thaobk91/smf/ảnh/netajet_high_flow_installation.jpg

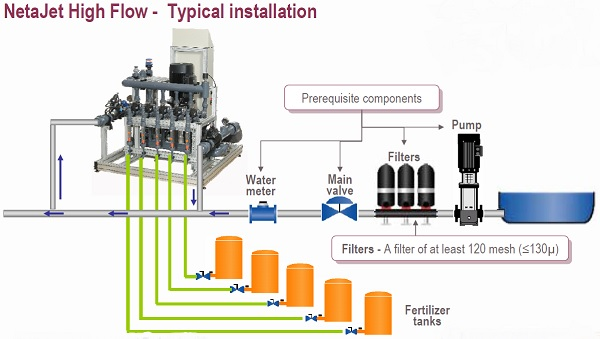
ảnh/netajet_high_flow_installation.jpg
