thaobk91/smf/ảnh/CMT-2.png

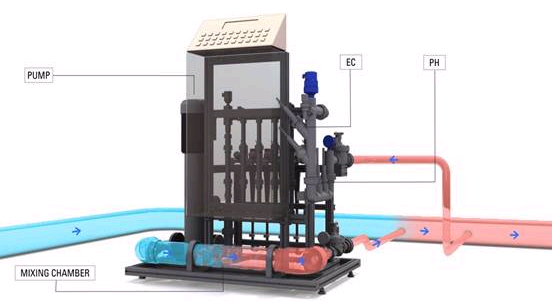
ảnh/CMT-2.png
