thaobk91/smf/image.png

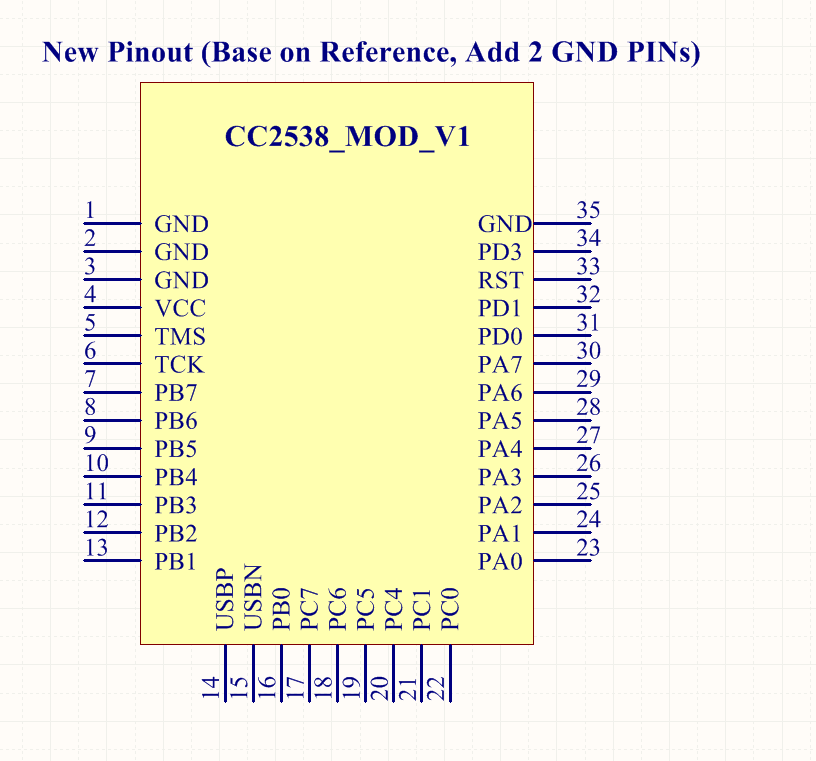
image.png
