thaobk91/smf/ảnh/cmt4.jpg

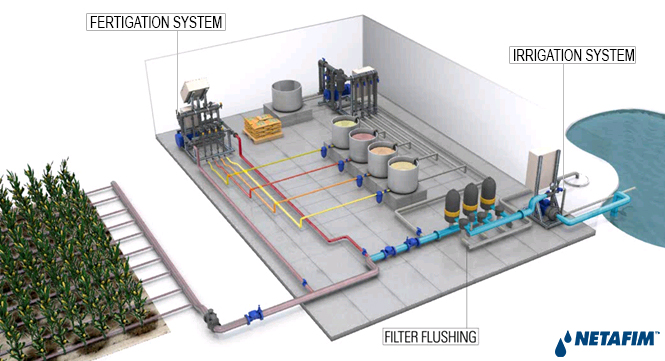
ảnh/cmt4.jpg
