thaobk91/smf/ảnh/FertirrigacionXILEMA2l.jpg

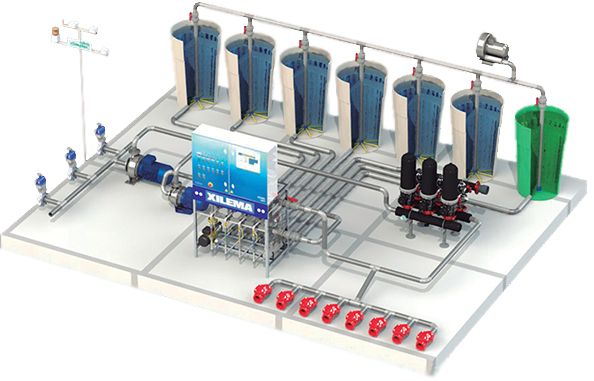
ảnh/FertirrigacionXILEMA2l.jpg
