thaobk91/smf/HW/Schematic Prints(3).PDF

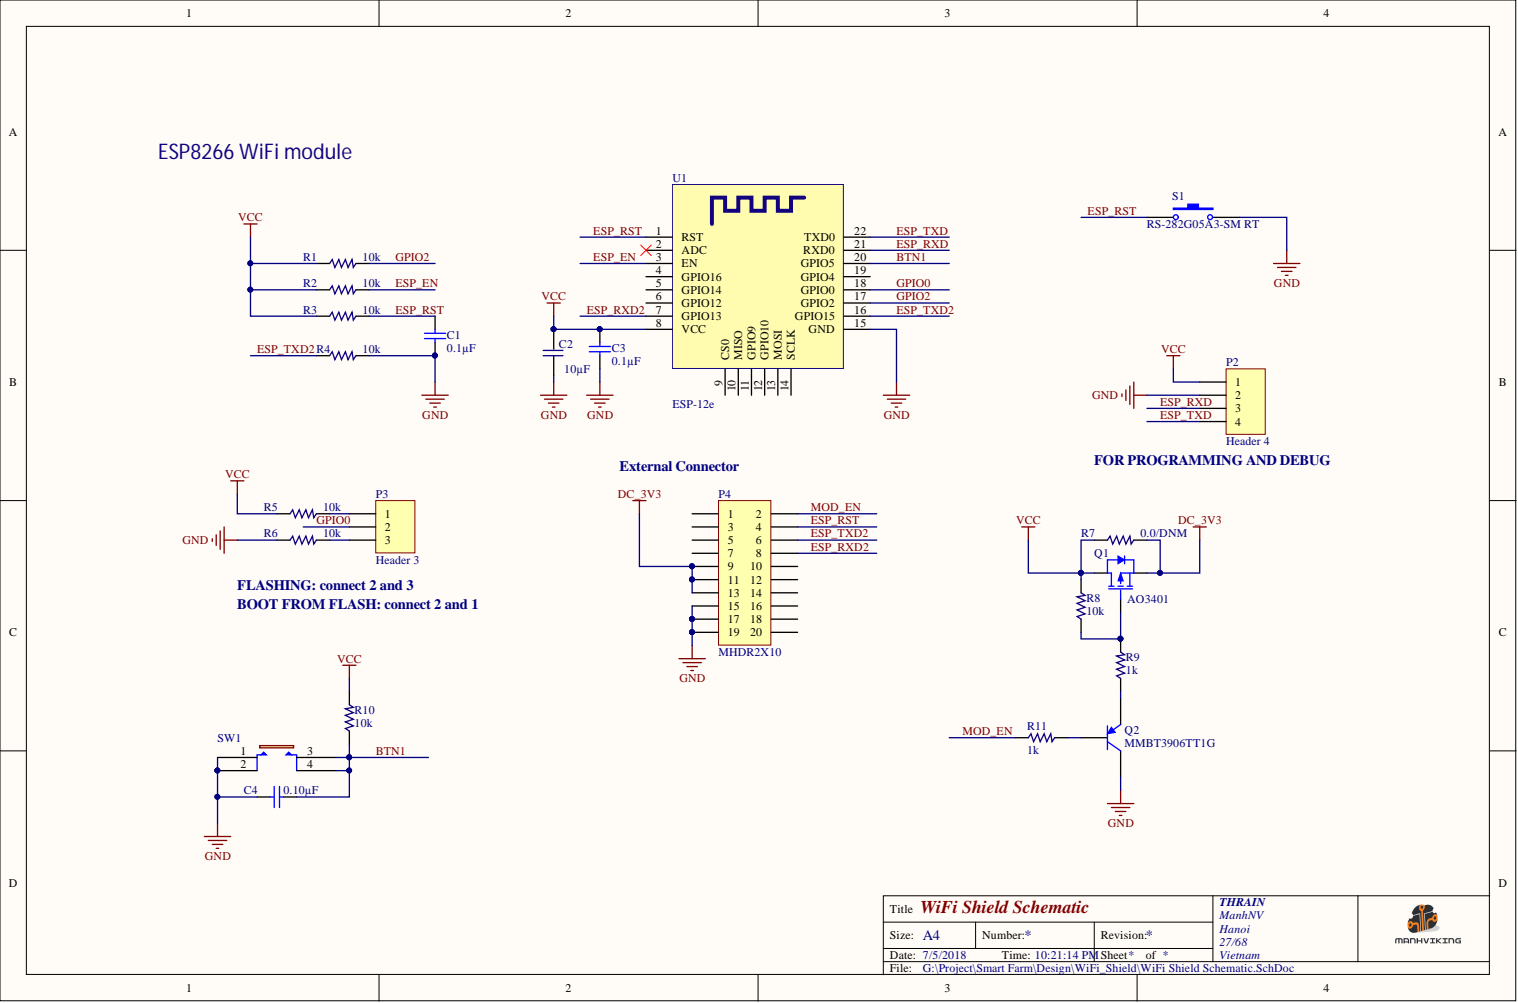
[picture p6: page 1]

FOR PROGRAMMING AND DEBUG

FLASHING: connect 2 and 3
BOOT FROM FLASH: connect 2 and 1

Title WiFi Shield Schematic | THRAIN ManhNV Hanoi 27/68 Vietnam

Size: A4 | Number: * | Revision: *
Date: 7/5/2018 Time: 10:21:14 PM | | Sheet * of *

G:\Project\Smart Farm\Design\WiFi_Shield\WiFi Shield Schematic.SchDoc
