thaobk91/smf/HW/WiFi_Shield 182806/PDF/Schematic Prints.PDF

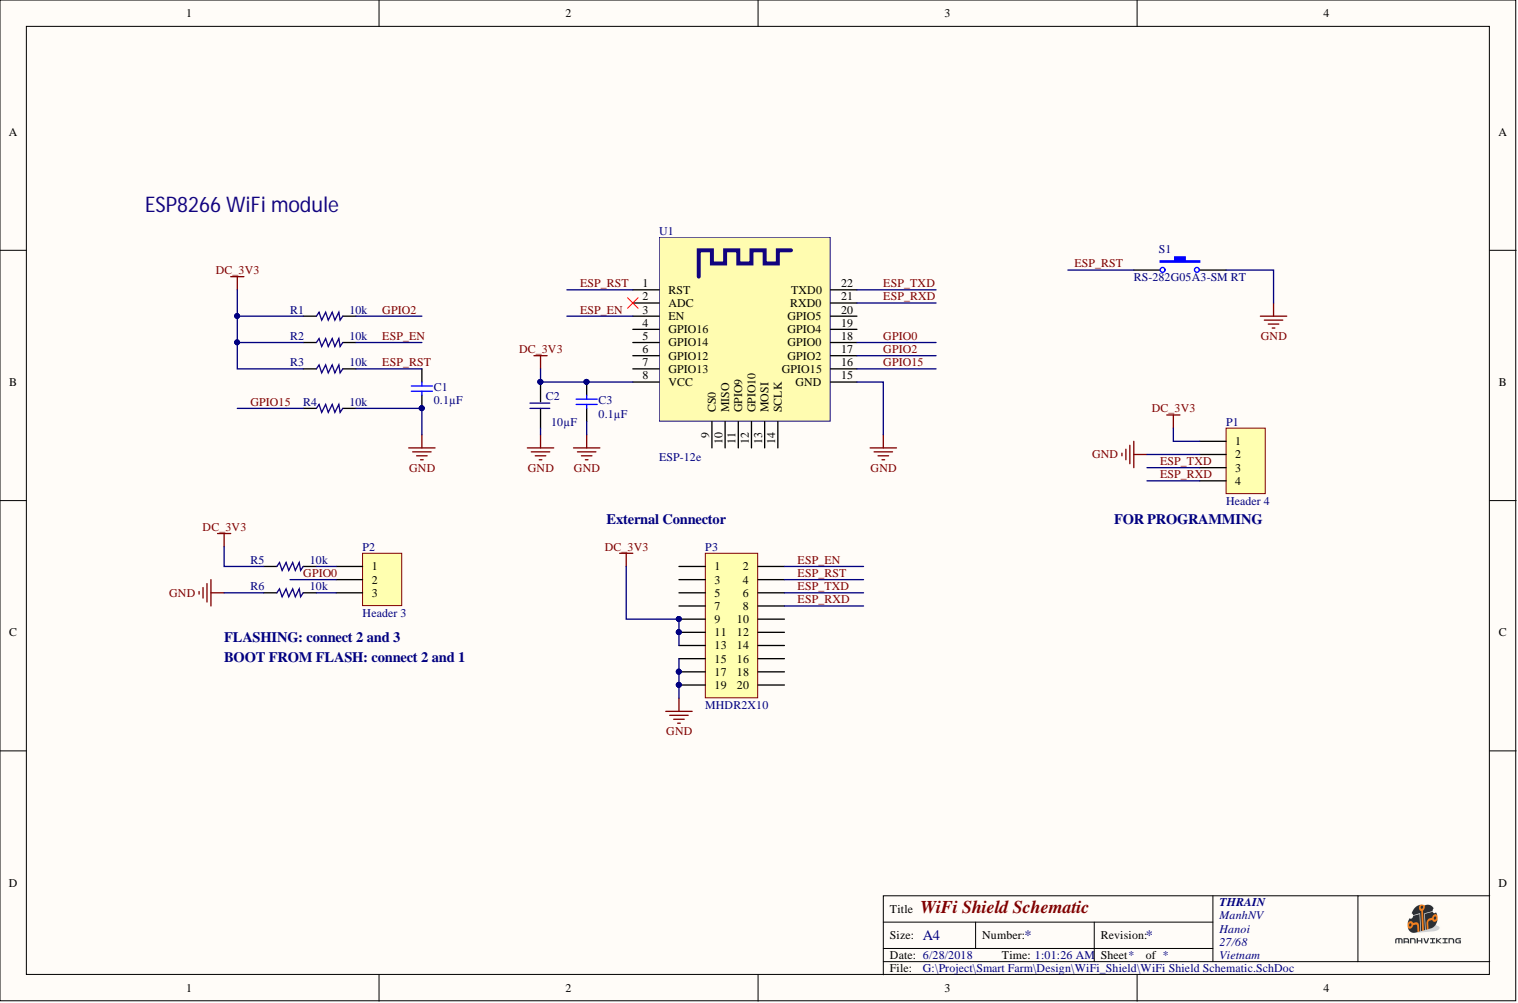
[picture p7: page 1]

FLASHING: connect 2 and 3
BOOT FROM FLASH: connect 2 and 1

Title WiFi Shield Schematic | THRAIN ManhNV Hanoi 27/68 Vietnam

Size: A4 | Number: * | Revision: *
Date: 6/28/2018 Time: 1:01:26 AM | | Sheet * of *

G:\Project\Smart Farm\Design\WiFi_Shield\WiFi Shield Schematic.SchDoc
