thaobk91/smf/HW/GatewayLayer.pdf

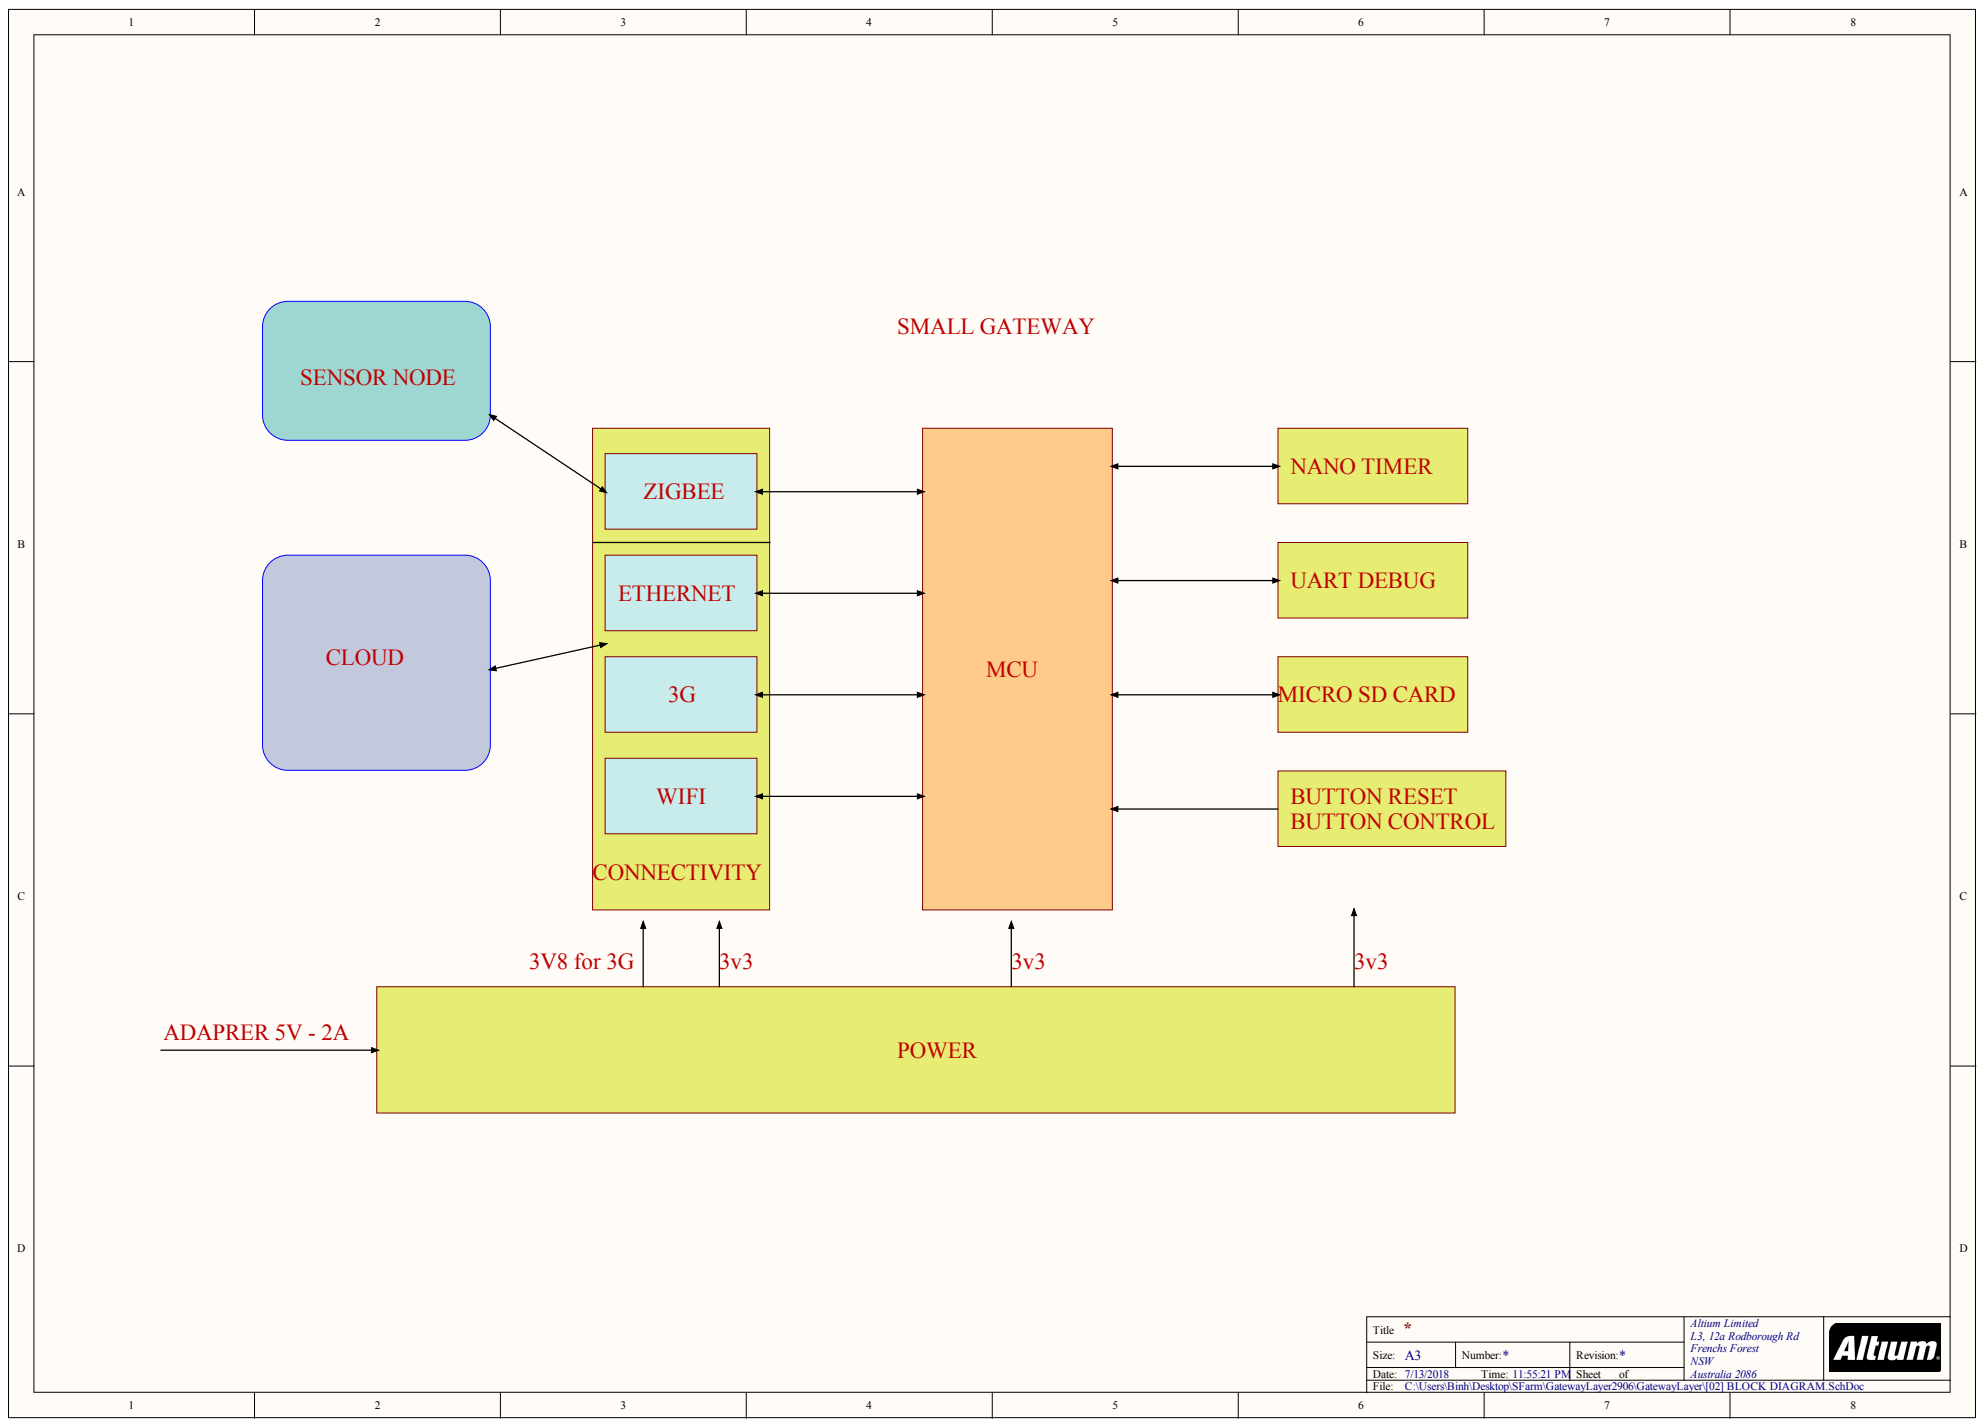
[picture p8: page 1]

* Title | Altium Limited L3, 12a Rodborough Rd Frenchs Forest NSW Australia 2086

Size: A3 | Number: * | Revision: *

Date: 7/13/2018 Time: 11:55:21 PM | | Sheet of

C:\Users\Binh\Desktop\SFarm\GatewayLayer2906\GatewayLayer\[02] BLOCK DIAGRAM.SchDoc

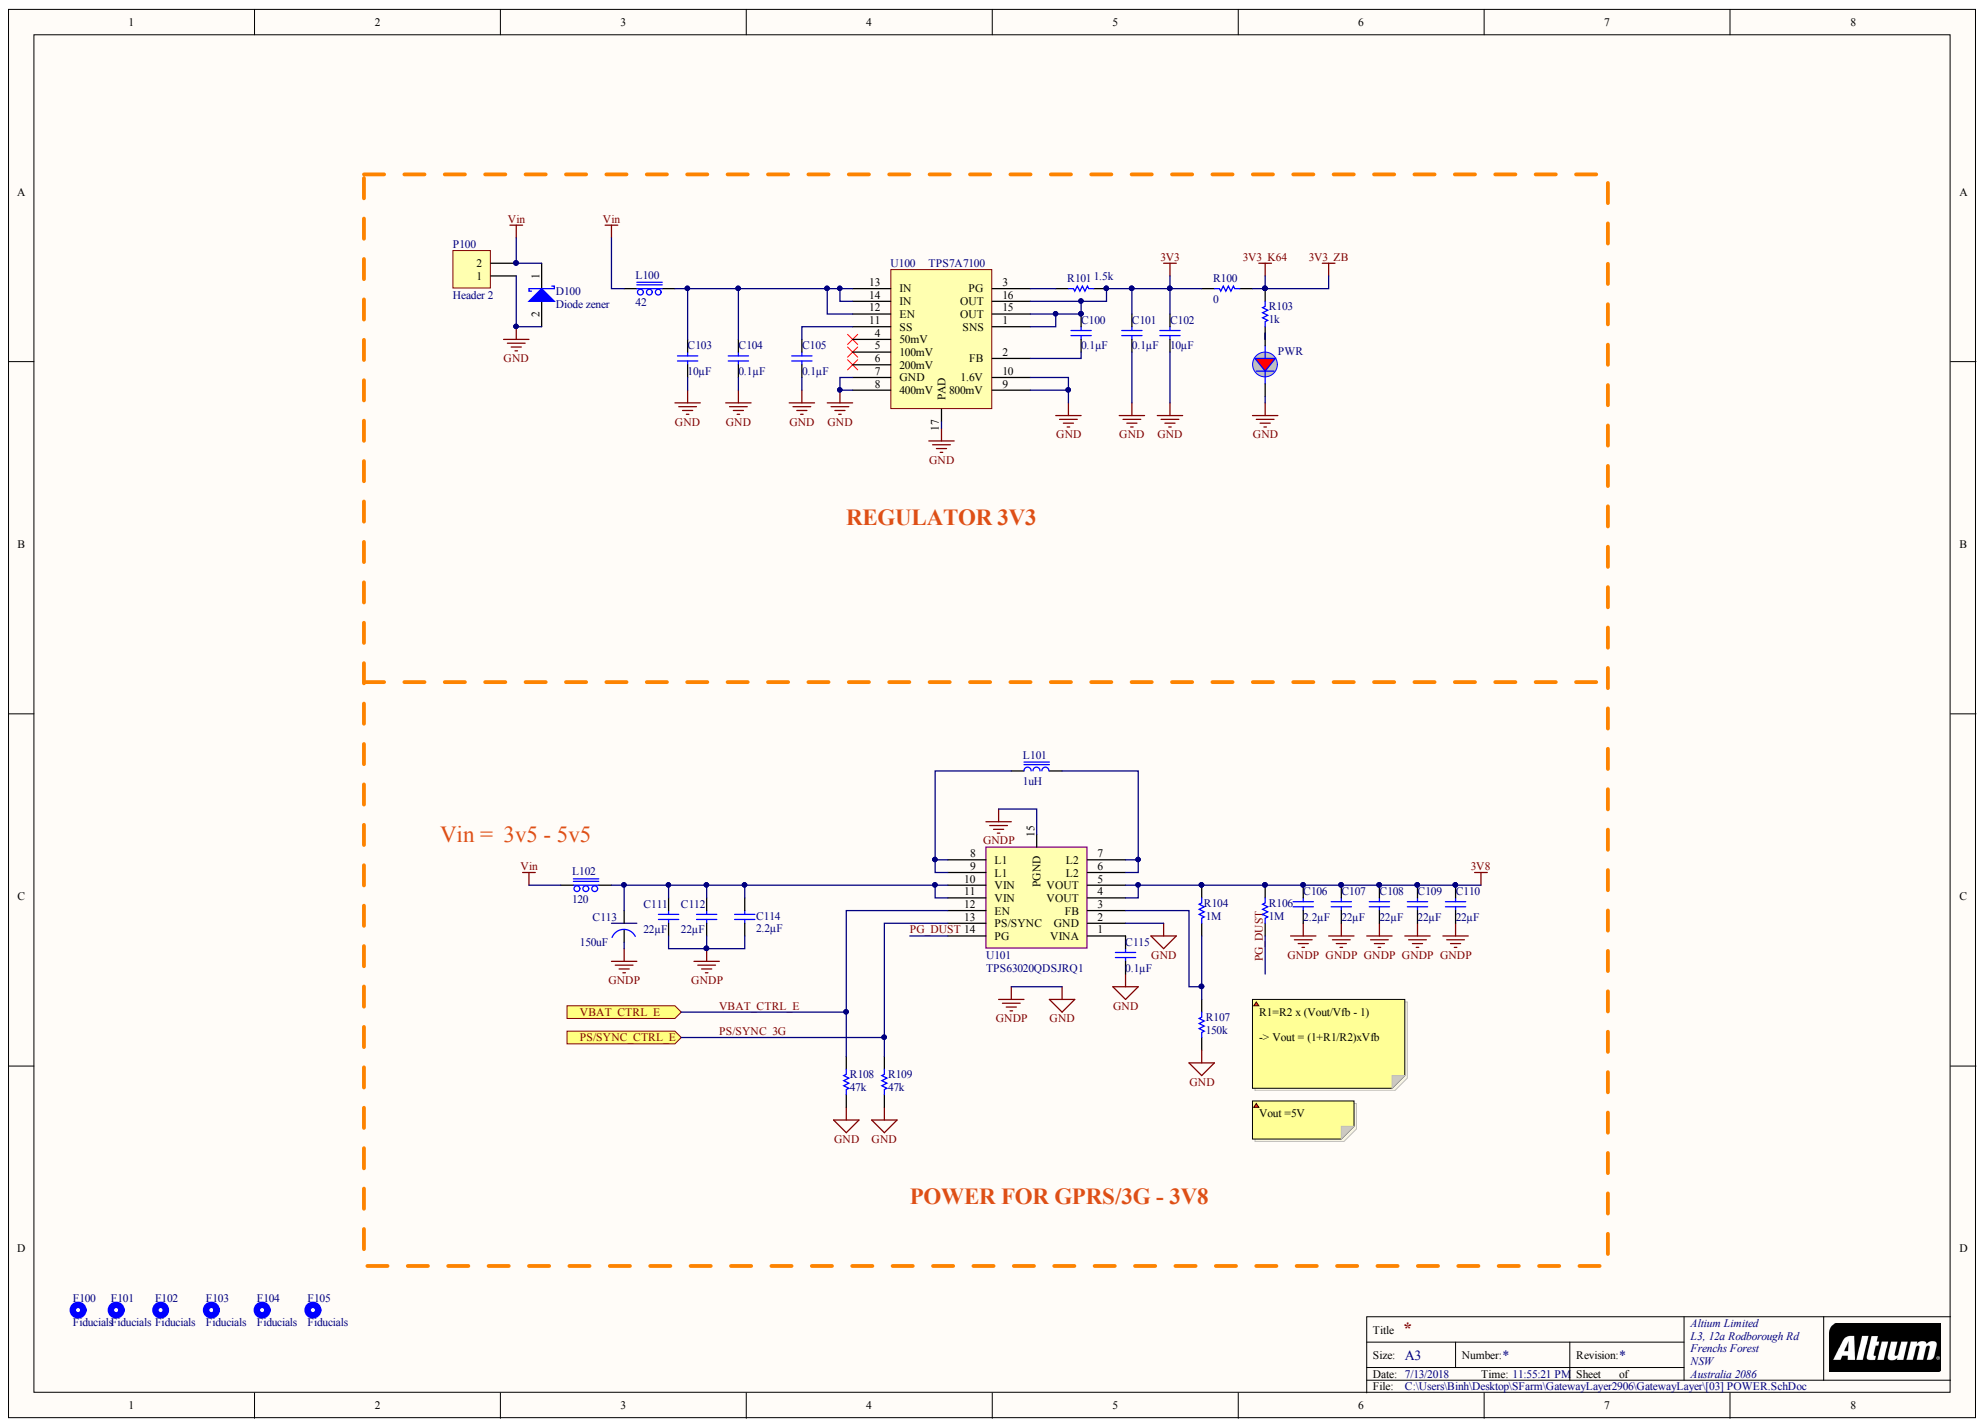
[picture p9: page 2]

C112 | | VIN 11

PS/SYNC 13 | | GND

GNDP GNDP GNDP GNDP GNDP

C:\Users\Binh\Desktop\SFarm\GatewayLayer2906\GatewayLayer\[03] POWER.SchDoc

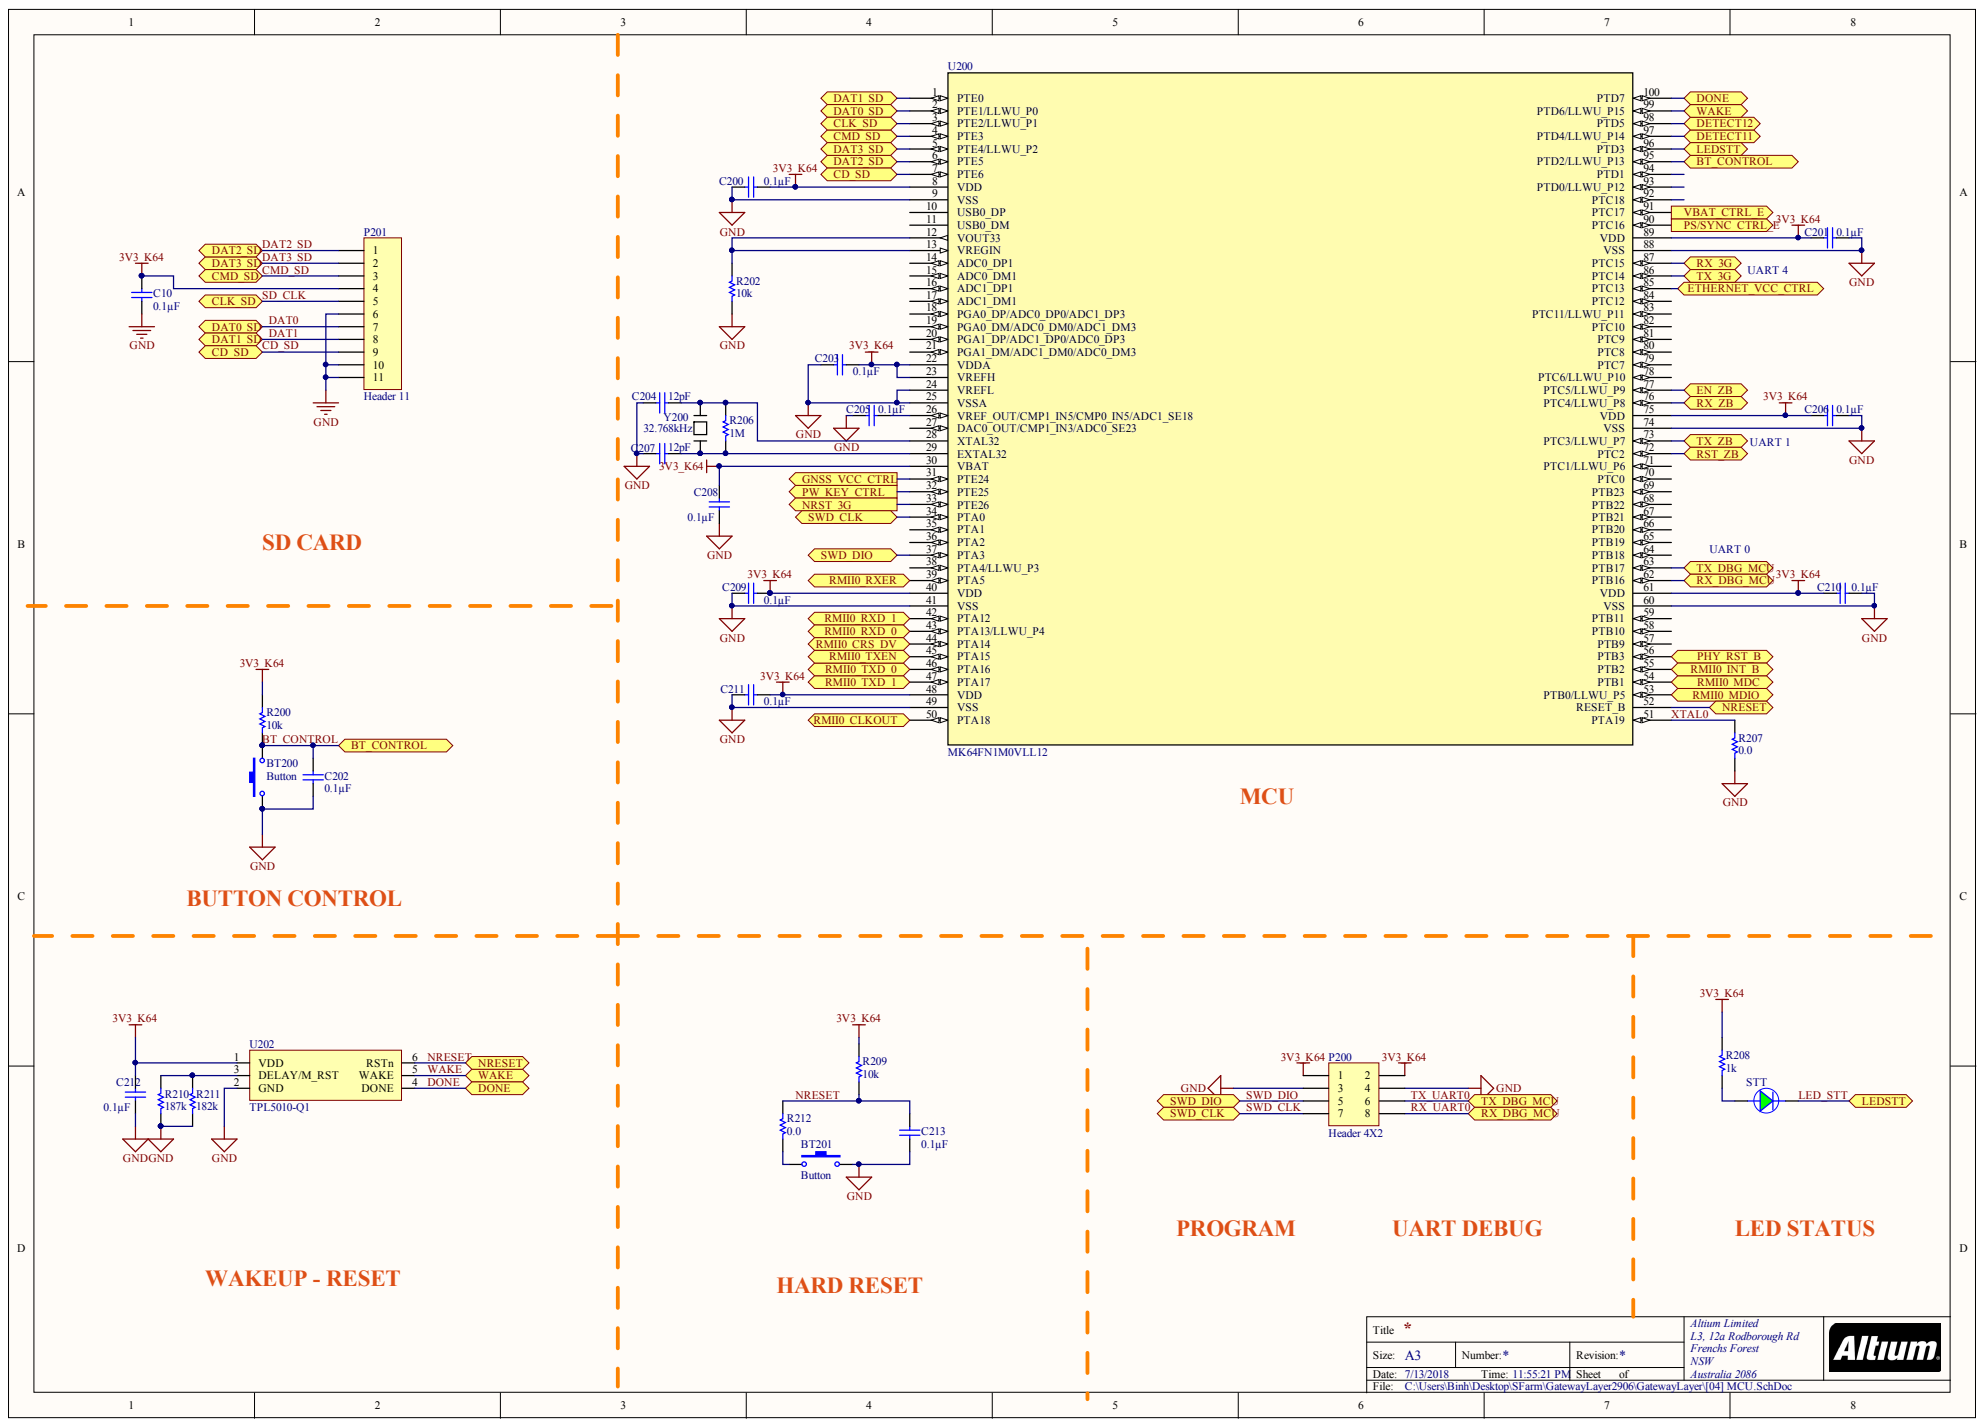
[picture p10: page 3]

VREFH 23

VSSA 25

VBAT 30

GNSS_VCC_CTRL | PTE24 31

C:\Users\Binh\Desktop\SFarm\GatewayLayer2906\GatewayLayer\[04] MCU.SchDoc

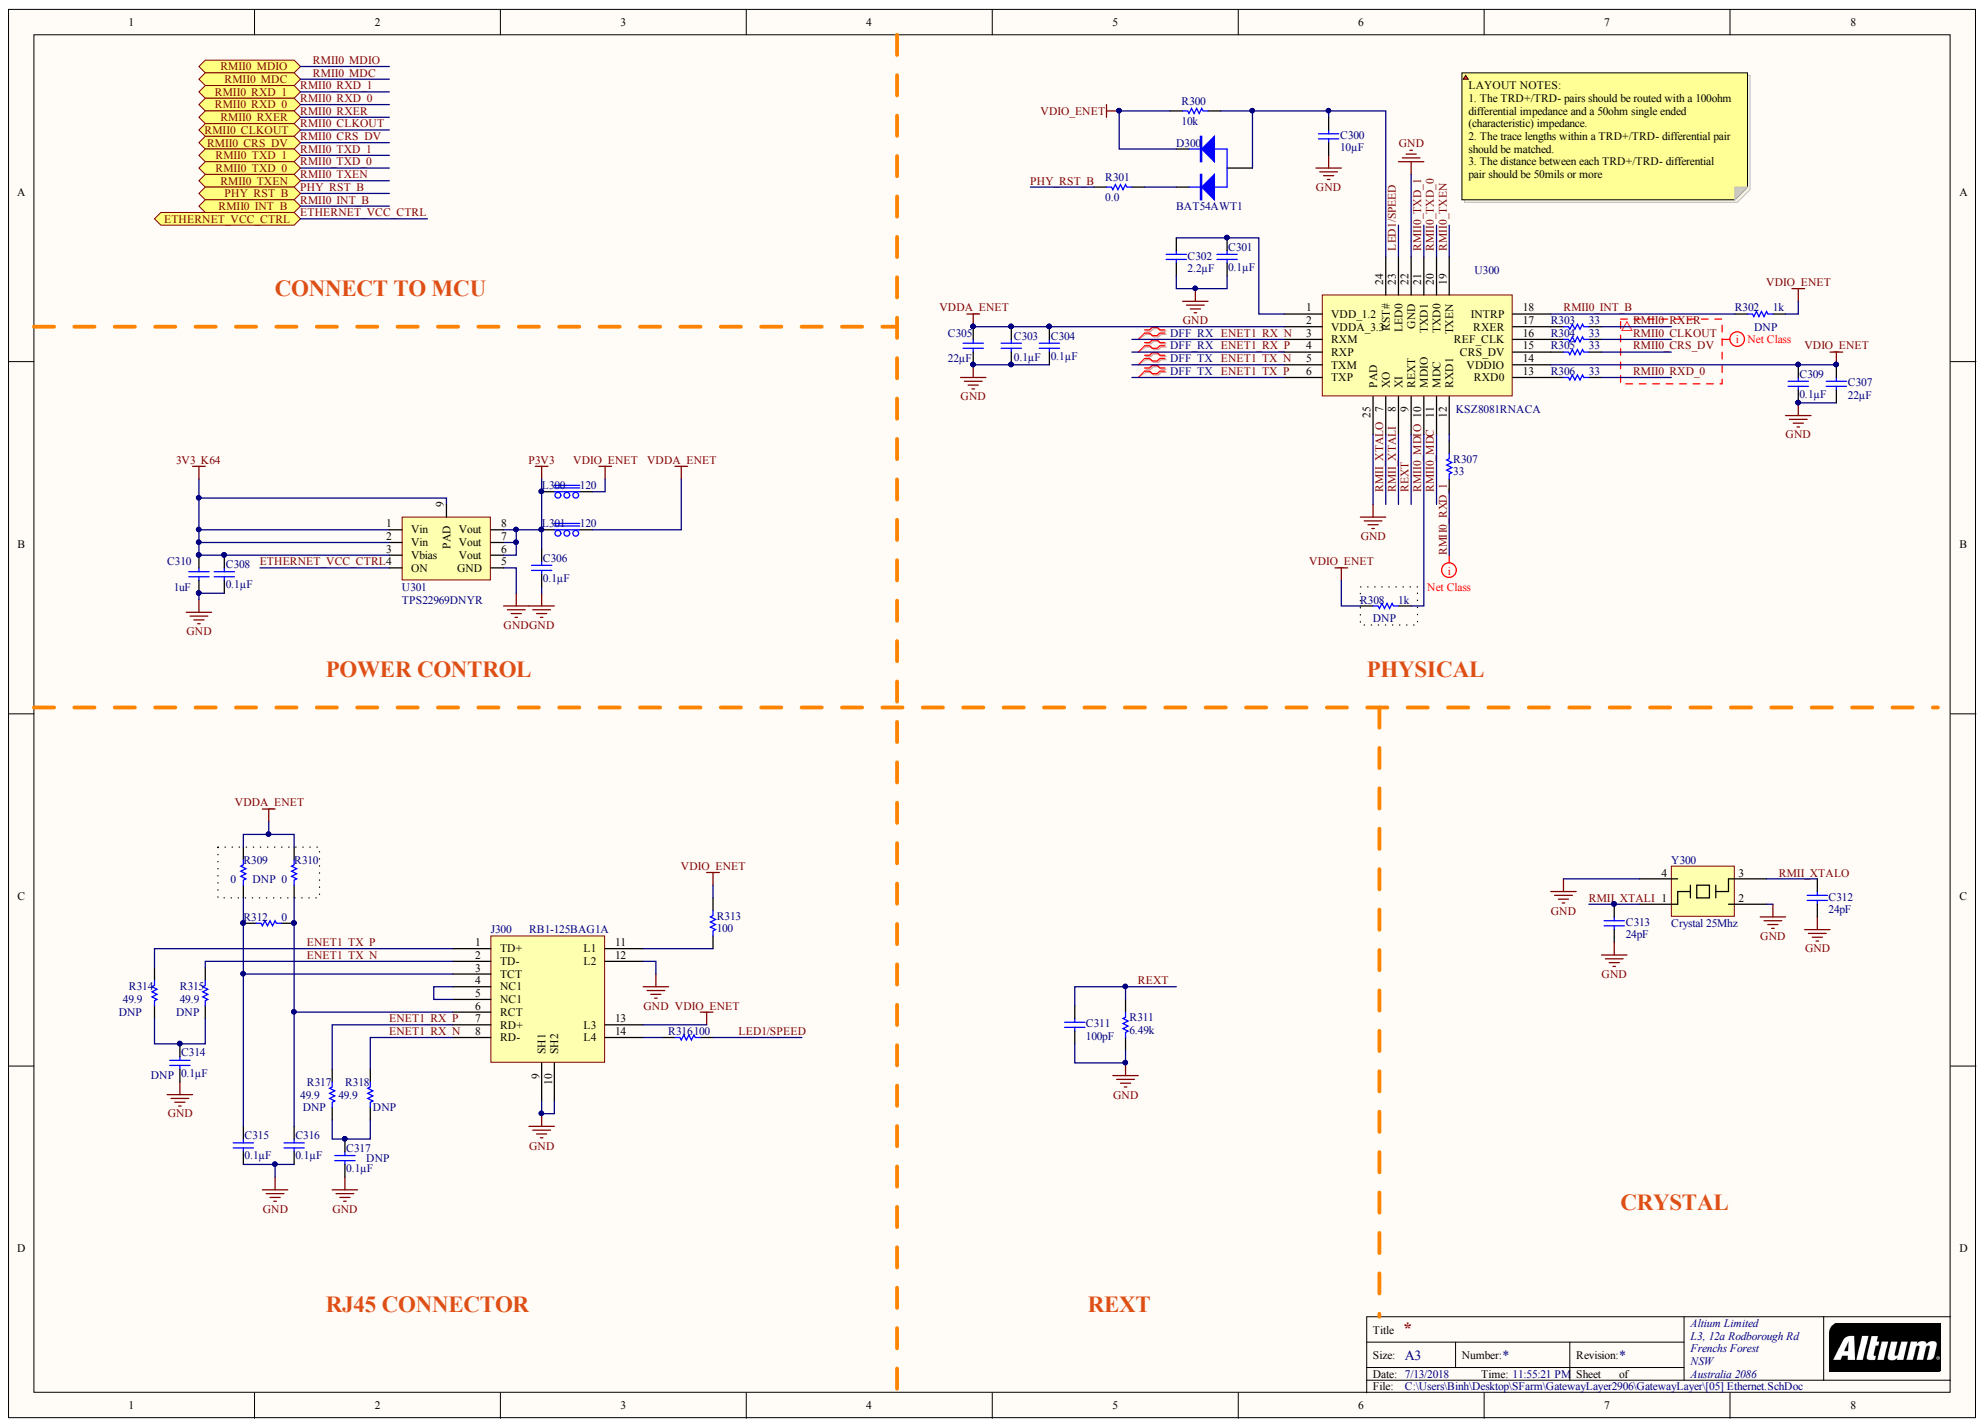
[picture p11: page 4]

LAYOUT NOTES:
1. The TRD+/TRD- pairs should be routed with a 100ohm
differential impedance and a 50ohm single ended
(characteristic) impedance.
2. The trace lengths within a TRD+/TRD- differential pair
should be matched.
3. The distance between each TRD+/TRD- differential
pair should be 50mils or more

TXEN 19 TXD0 20 TXD1 21 GND 22 LED0 23 RST# 24 PAD 25

ETHERNET_VCC_CTRL

ON 4 Vbias 3

ENET1_TX_N | | TD- 2 | GND VDIO_ENET

TCT 3
NC1 4
NC1 5

C:\Users\Binh\Desktop\SFarm\GatewayLayer2906\GatewayLayer\[05] Ethernet.SchDoc

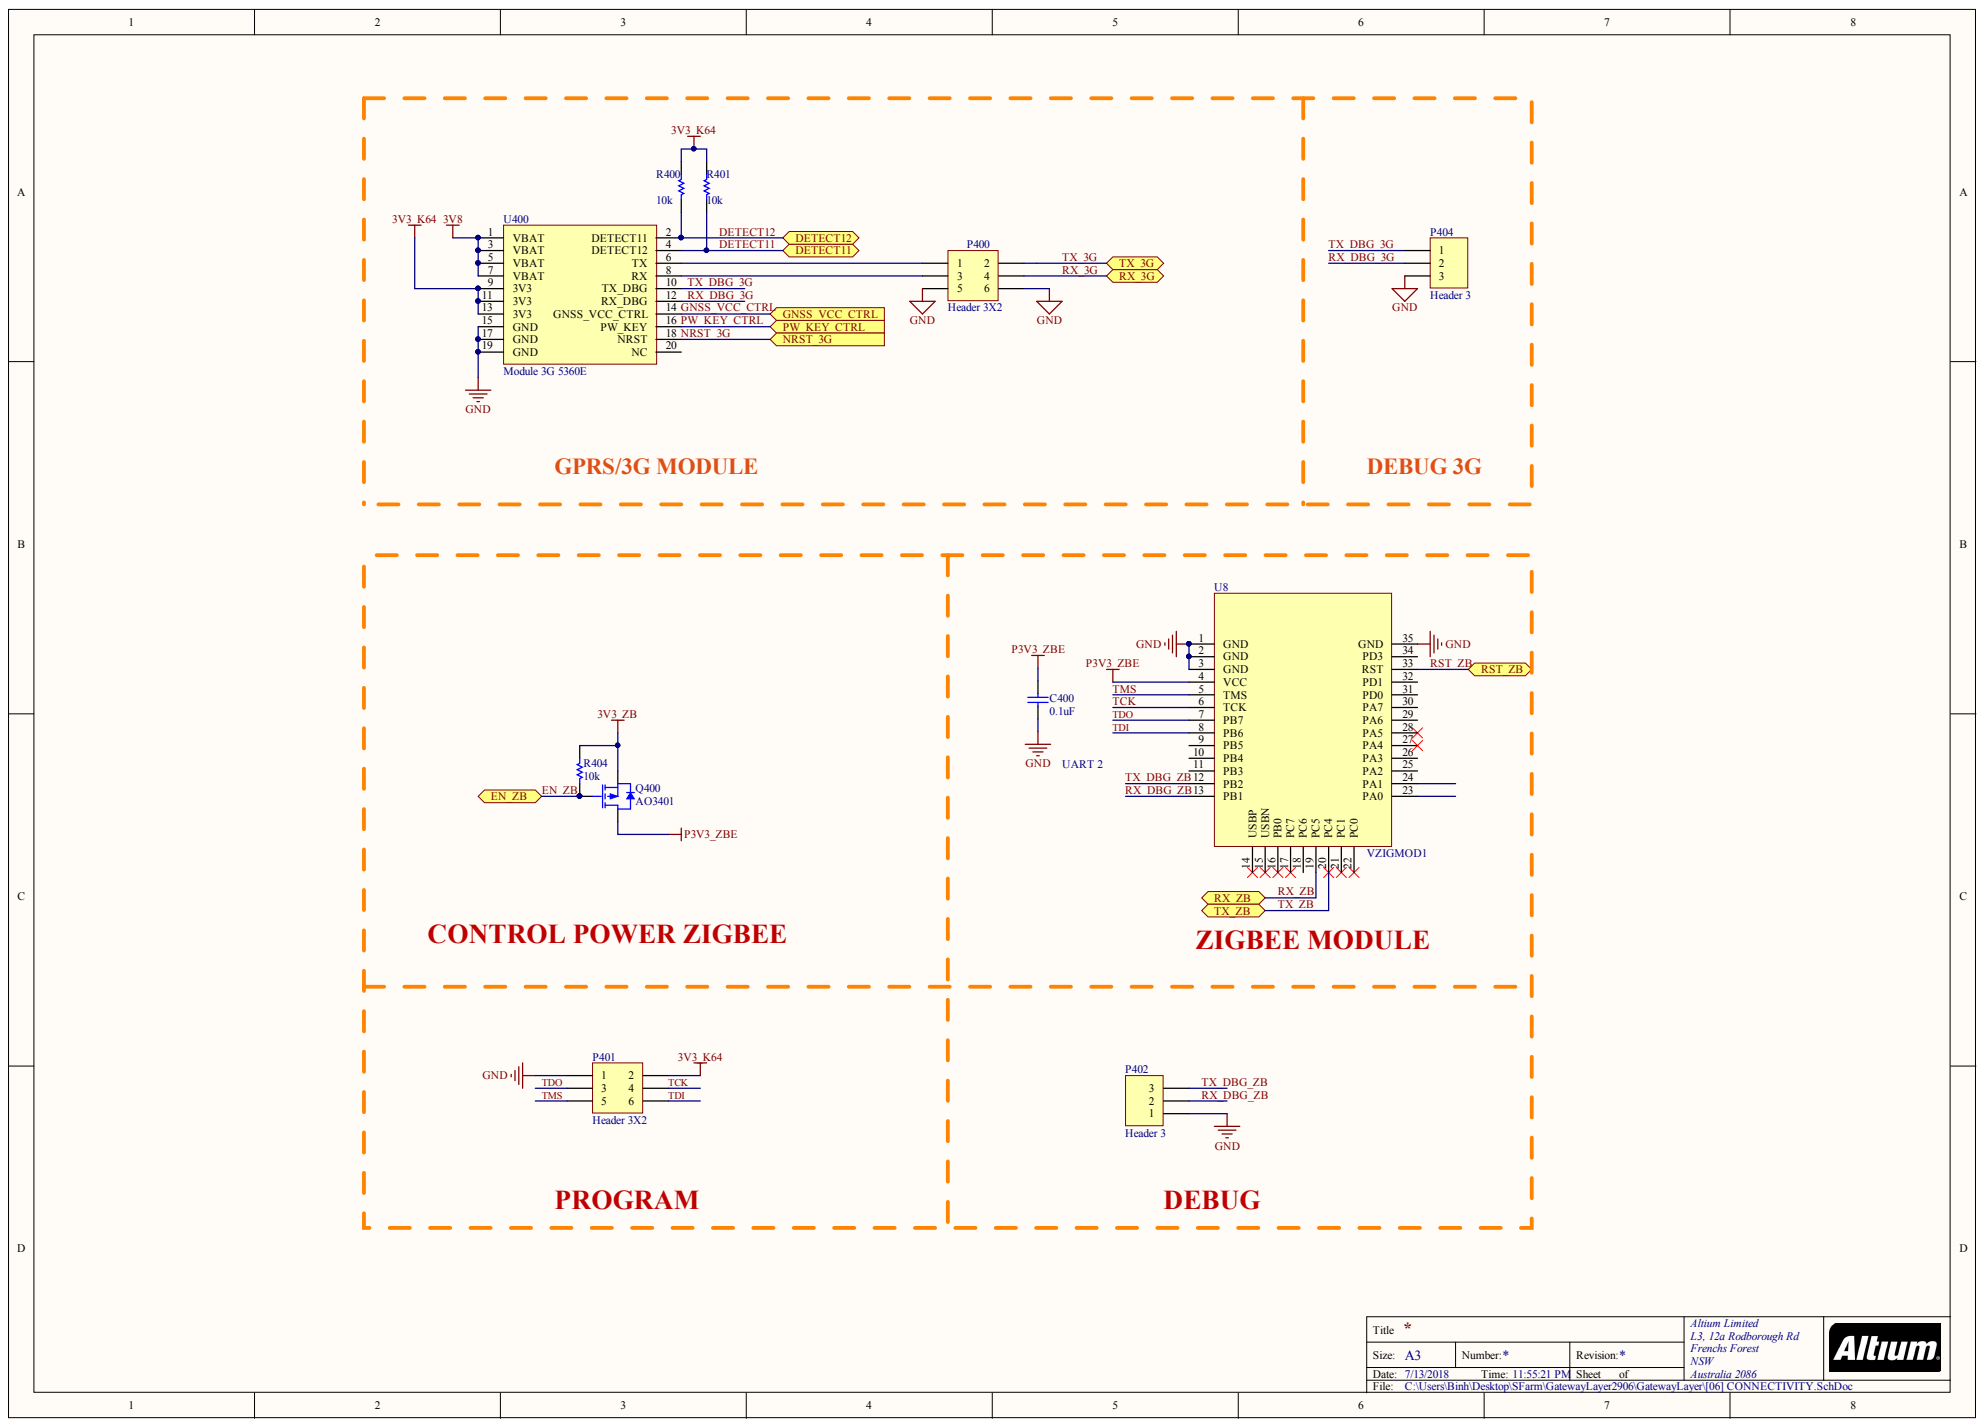
[picture p12: page 5]

C:\Users\Binh\Desktop\SFarm\GatewayLayer2906\GatewayLayer\[06] CONNECTIVITY.SchDoc

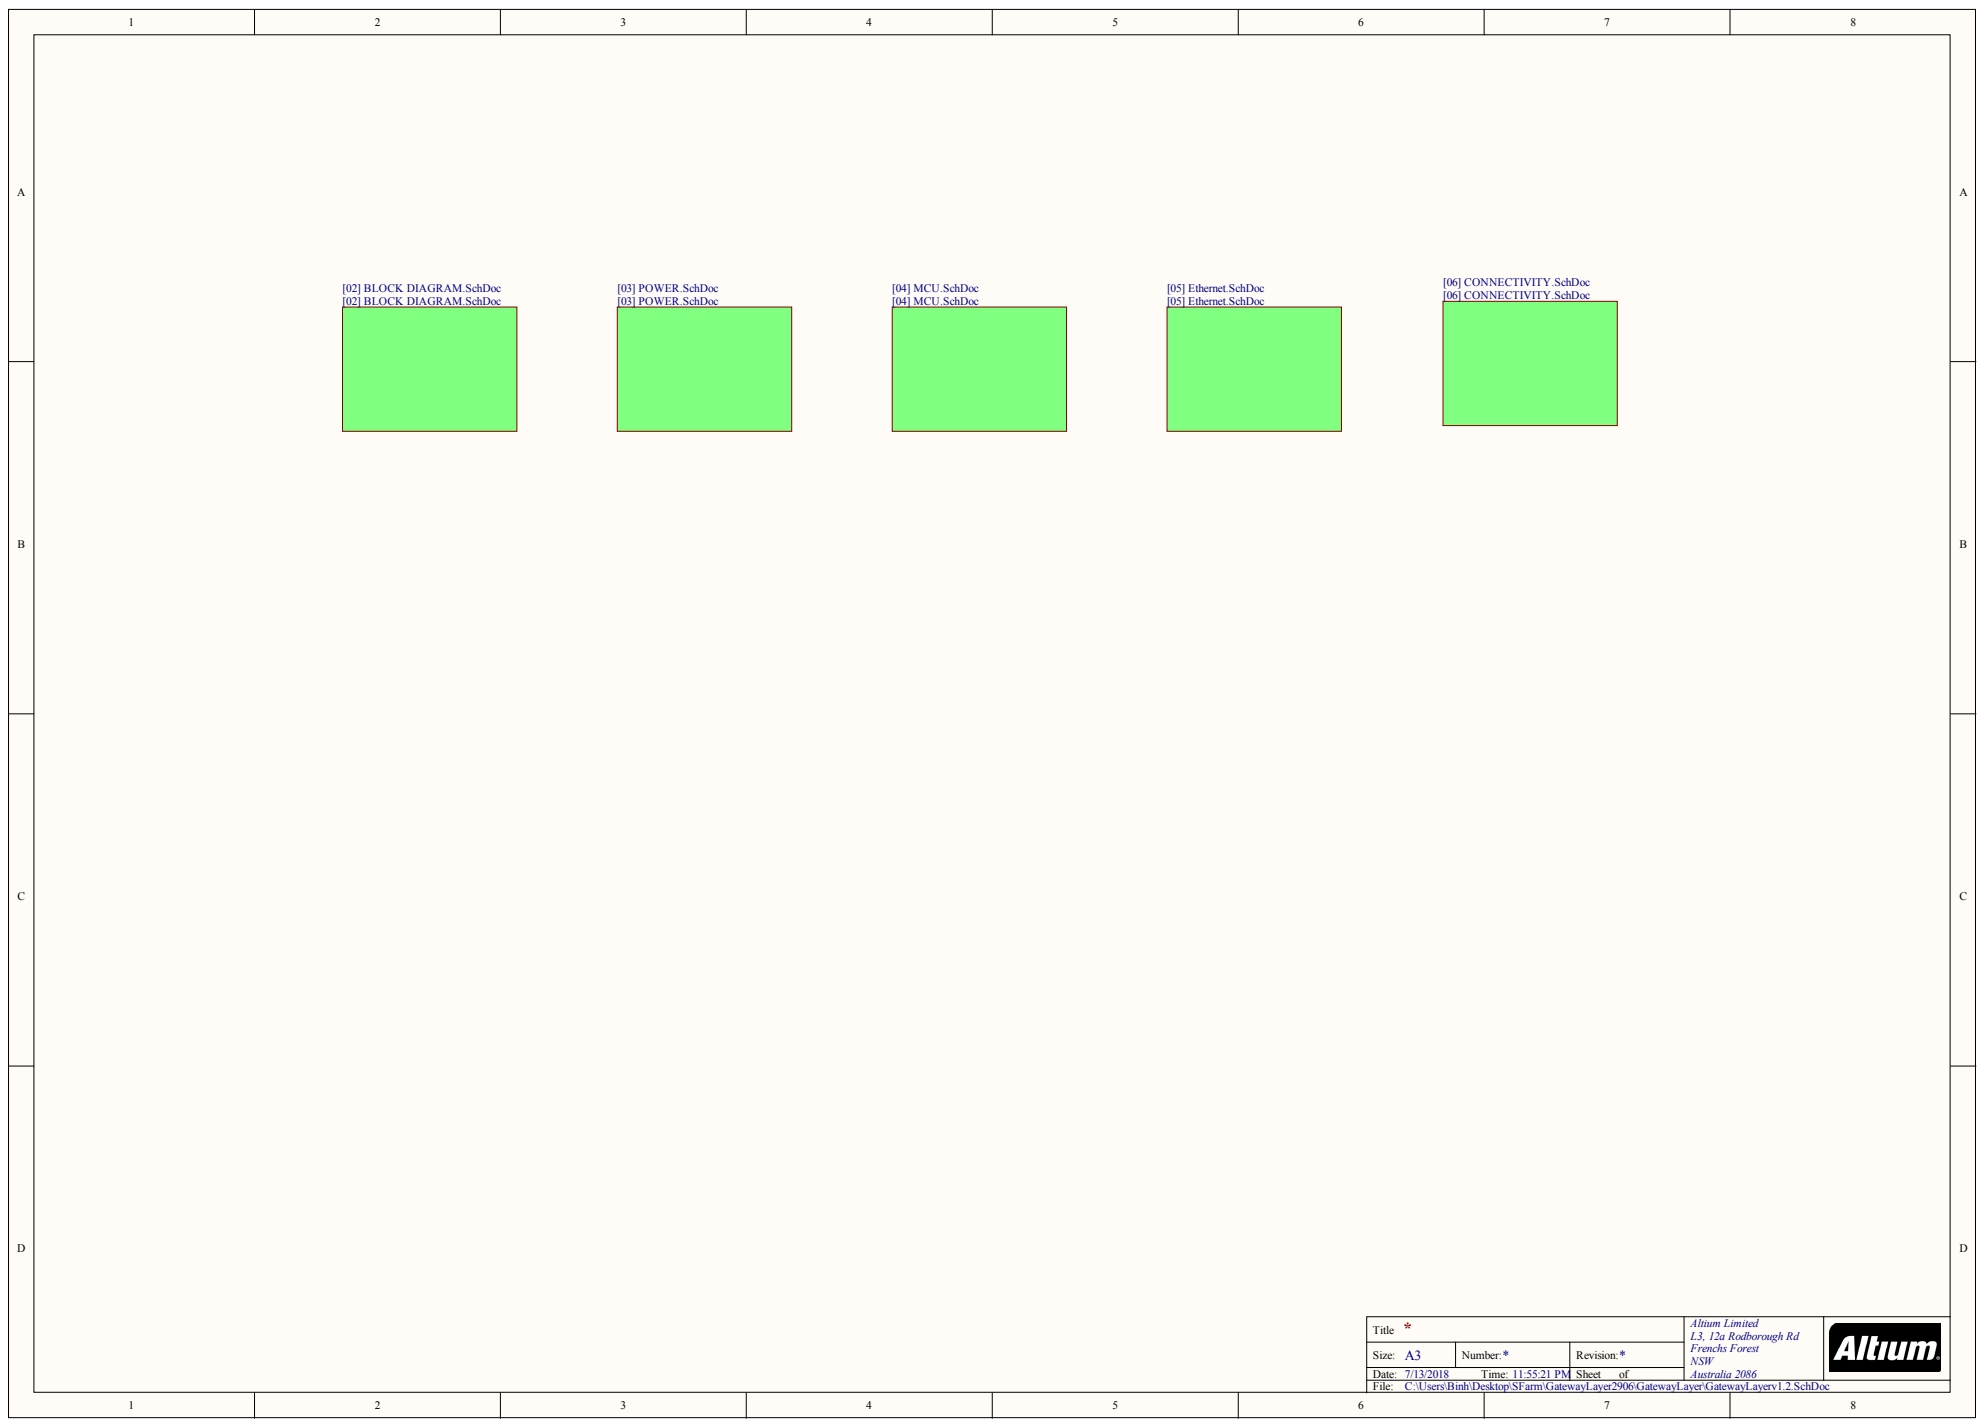
[picture p13: page 6]

C:\Users\Binh\Desktop\SFarm\GatewayLayer2906\GatewayLayer\GatewayLayerv1.2.SchDoc
