thaobk91/smf/HW/SensorNode.pdf

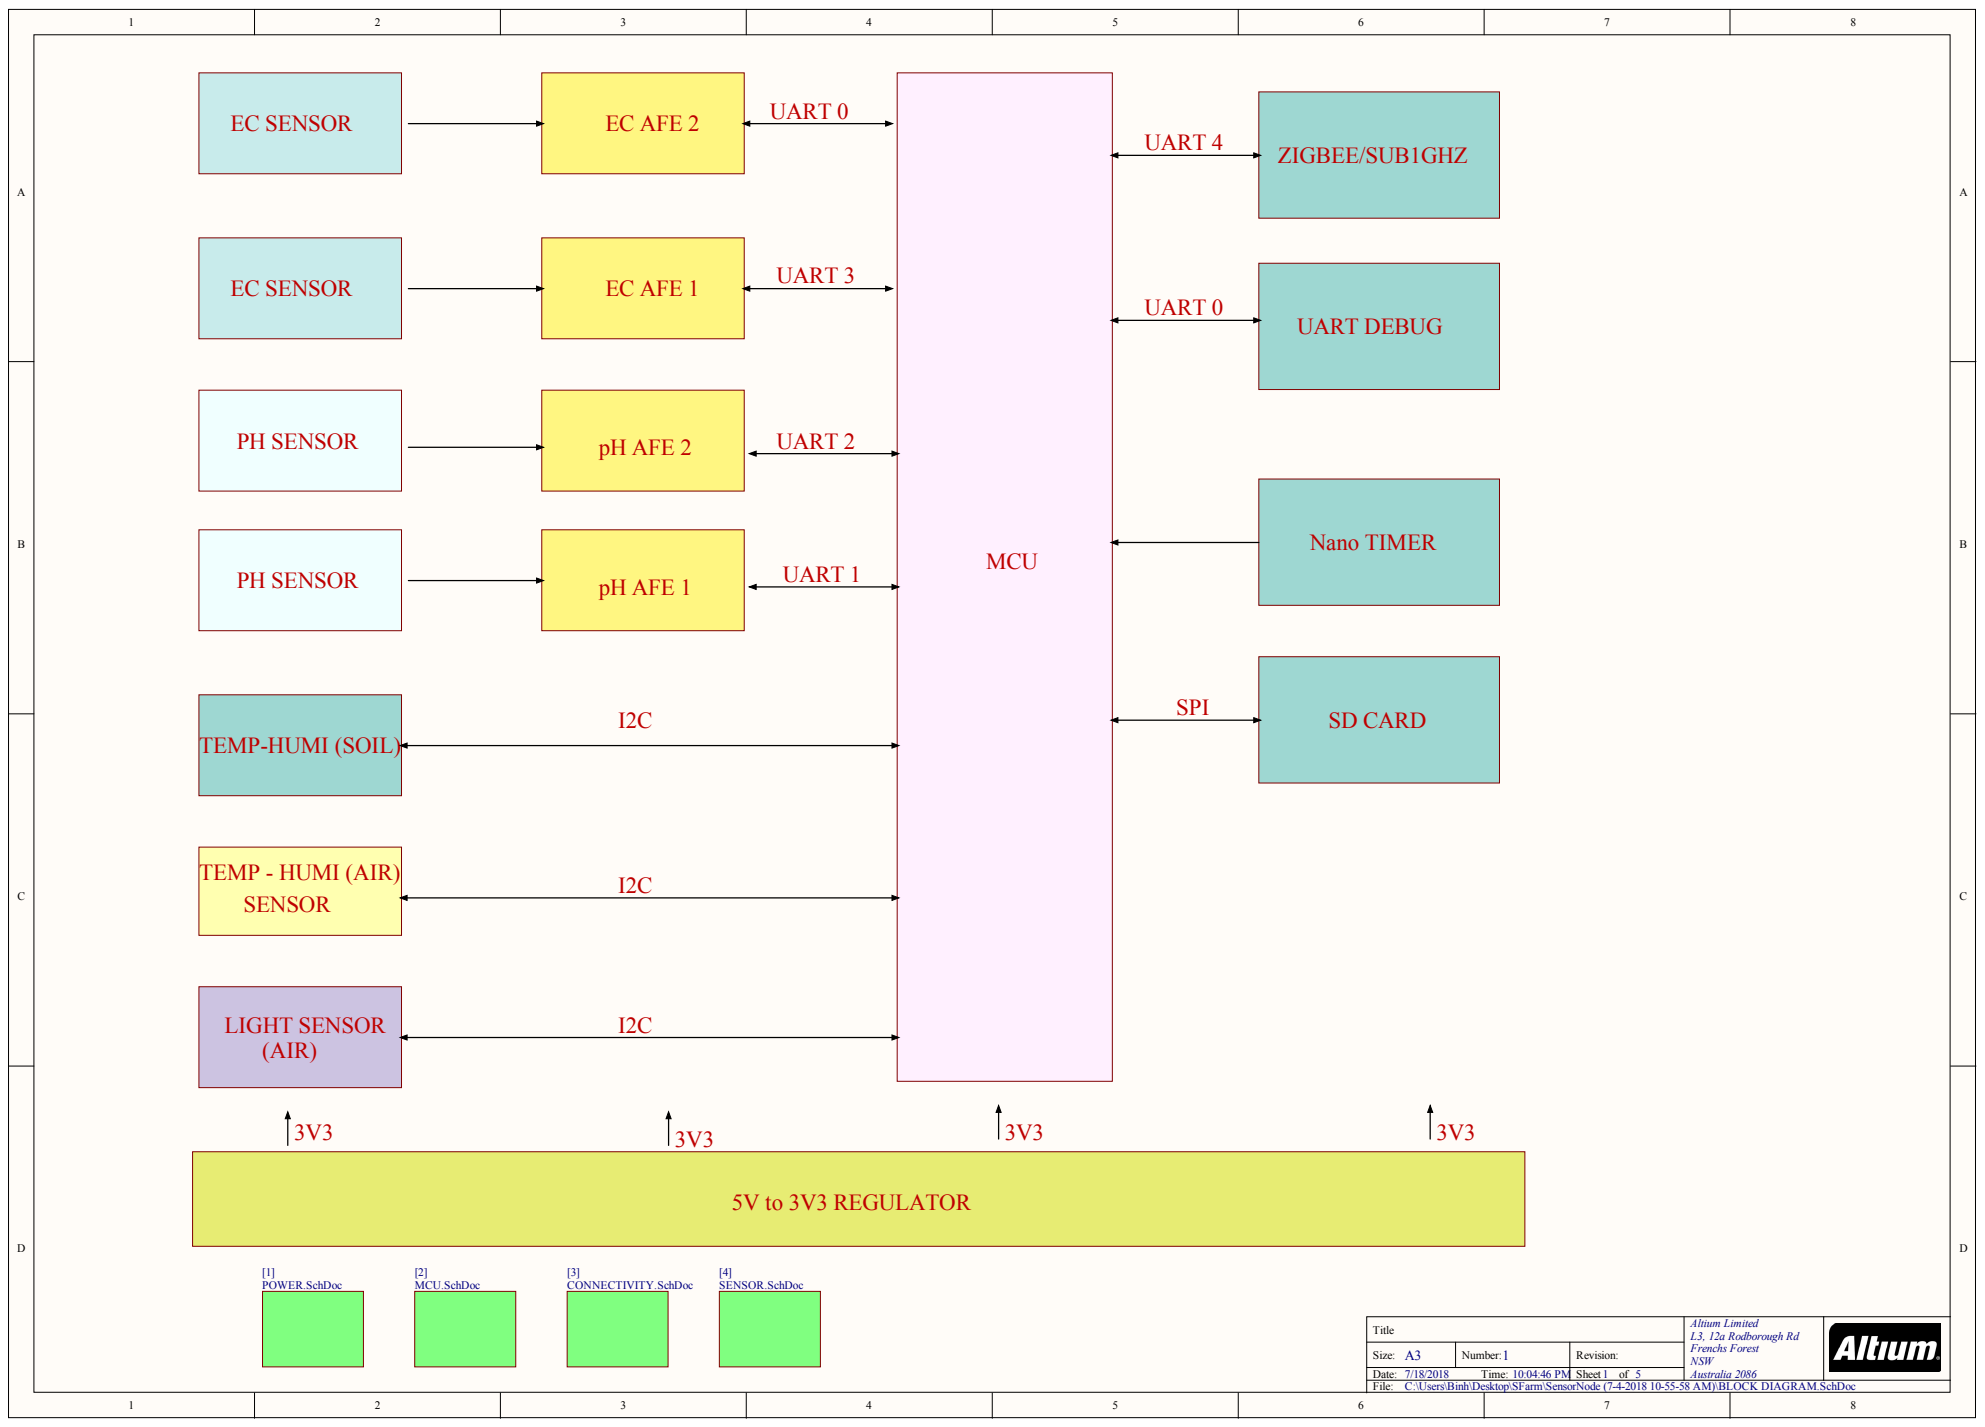
[picture p14: page 1]

pH AFE 2 PH SENSOR

Title | Altium Limited L3, 12a Rodborough Rd Frenchs Forest NSW Australia 2086

Size: A3 | Number: | Revision:

Date: 7/18/2018 Time: 10:04:46 PM | | Sheet of 5

C:\Users\Binh\Desktop\SFarm\SensorNode (7-4-2018 10-55-58 AM)\BLOCK DIAGRAM.SchDoc

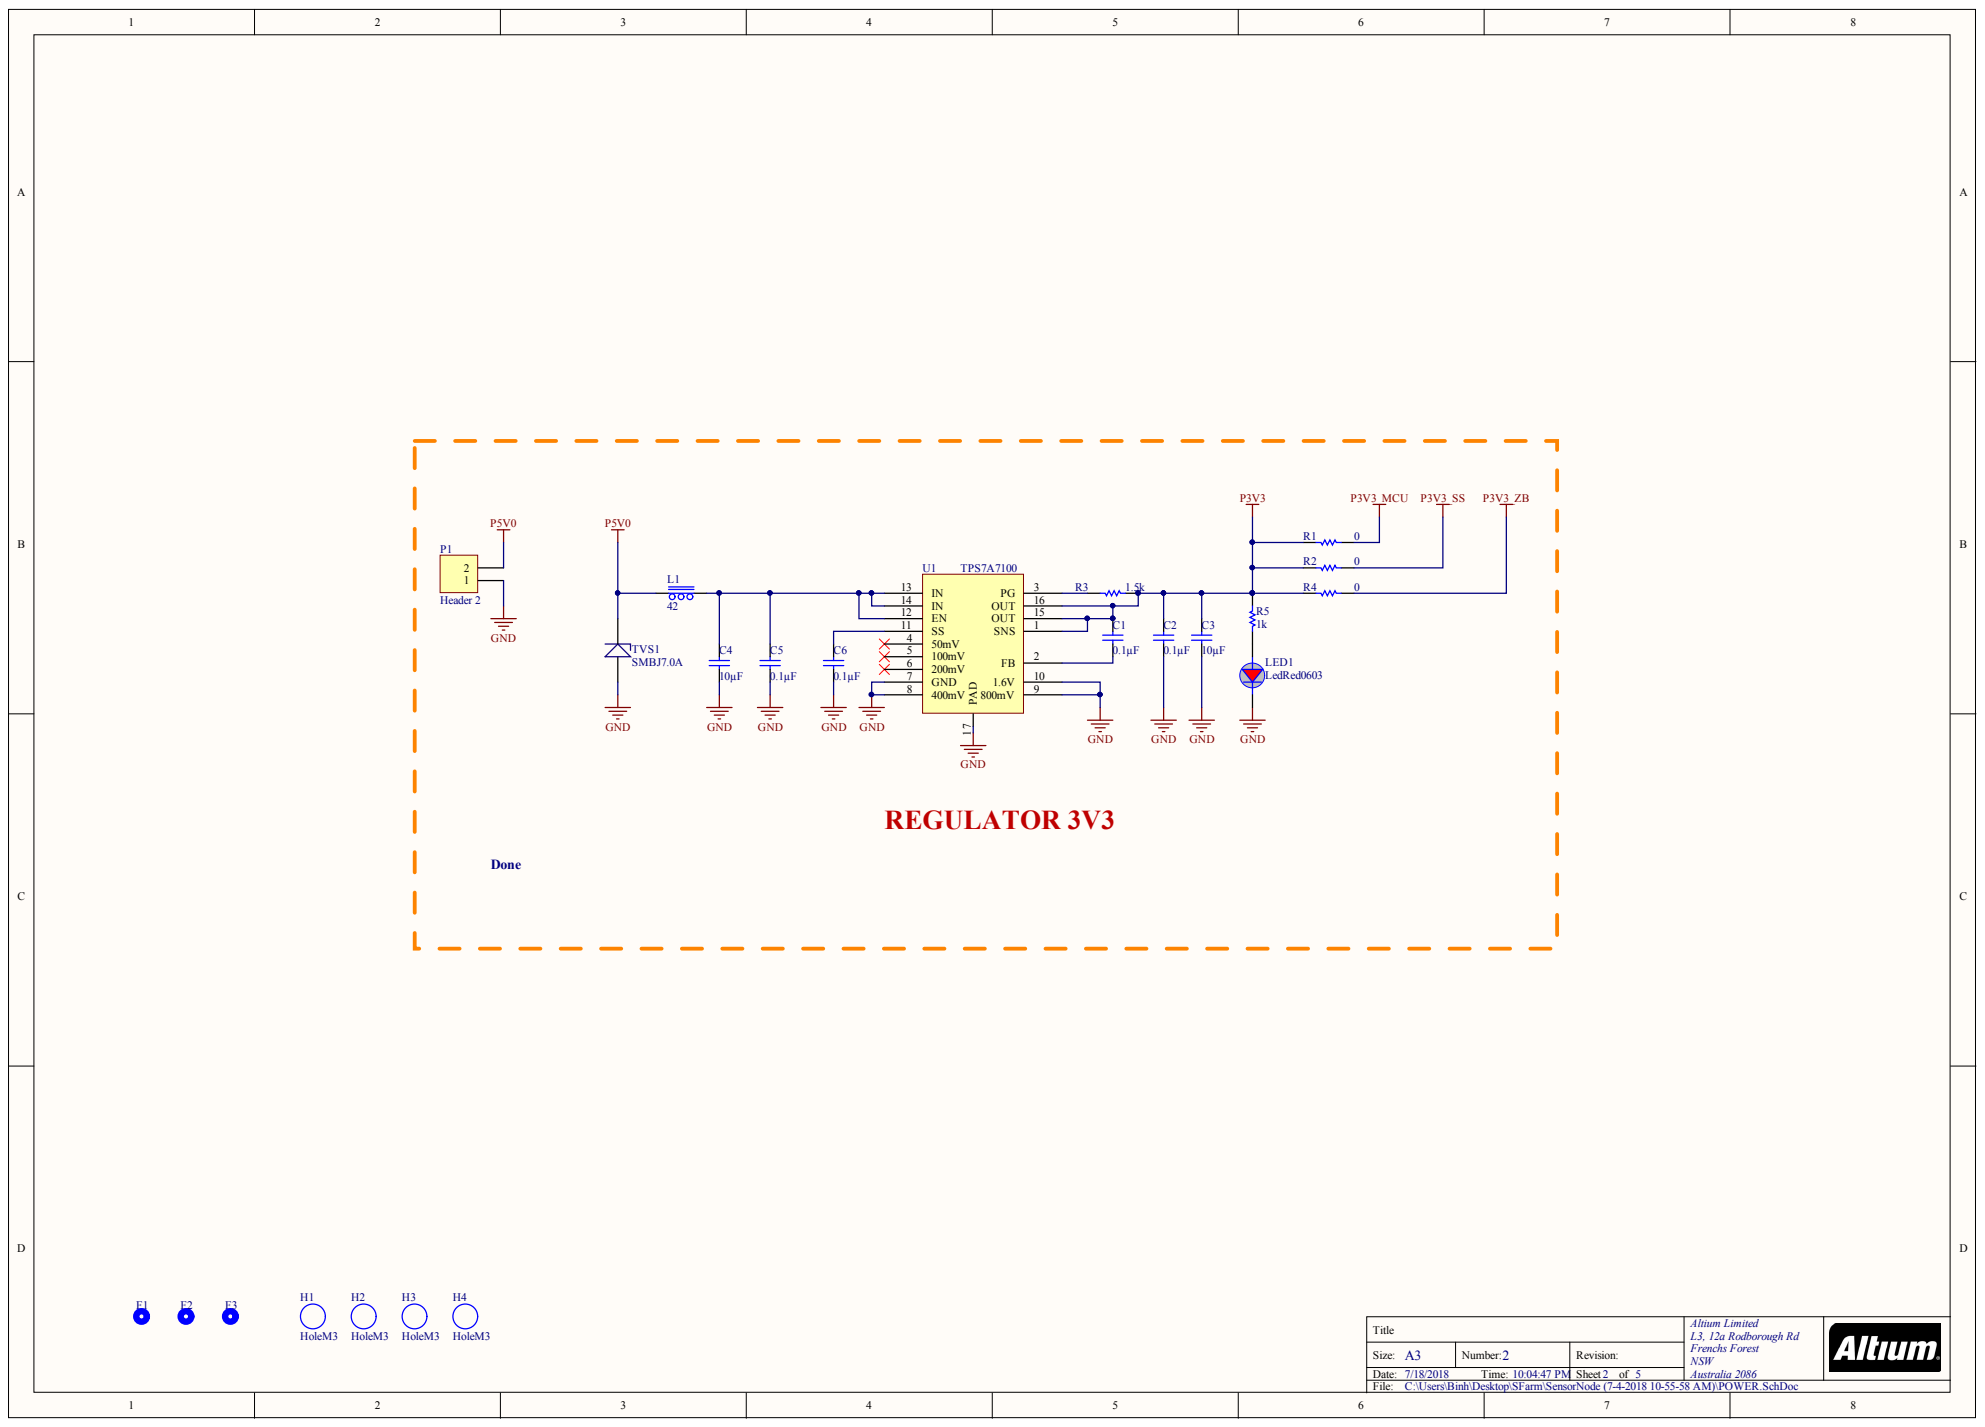
[picture p15: page 2]

C:\Users\Binh\Desktop\SFarm\SensorNode (7-4-2018 10-55-58 AM)\POWER.SchDoc

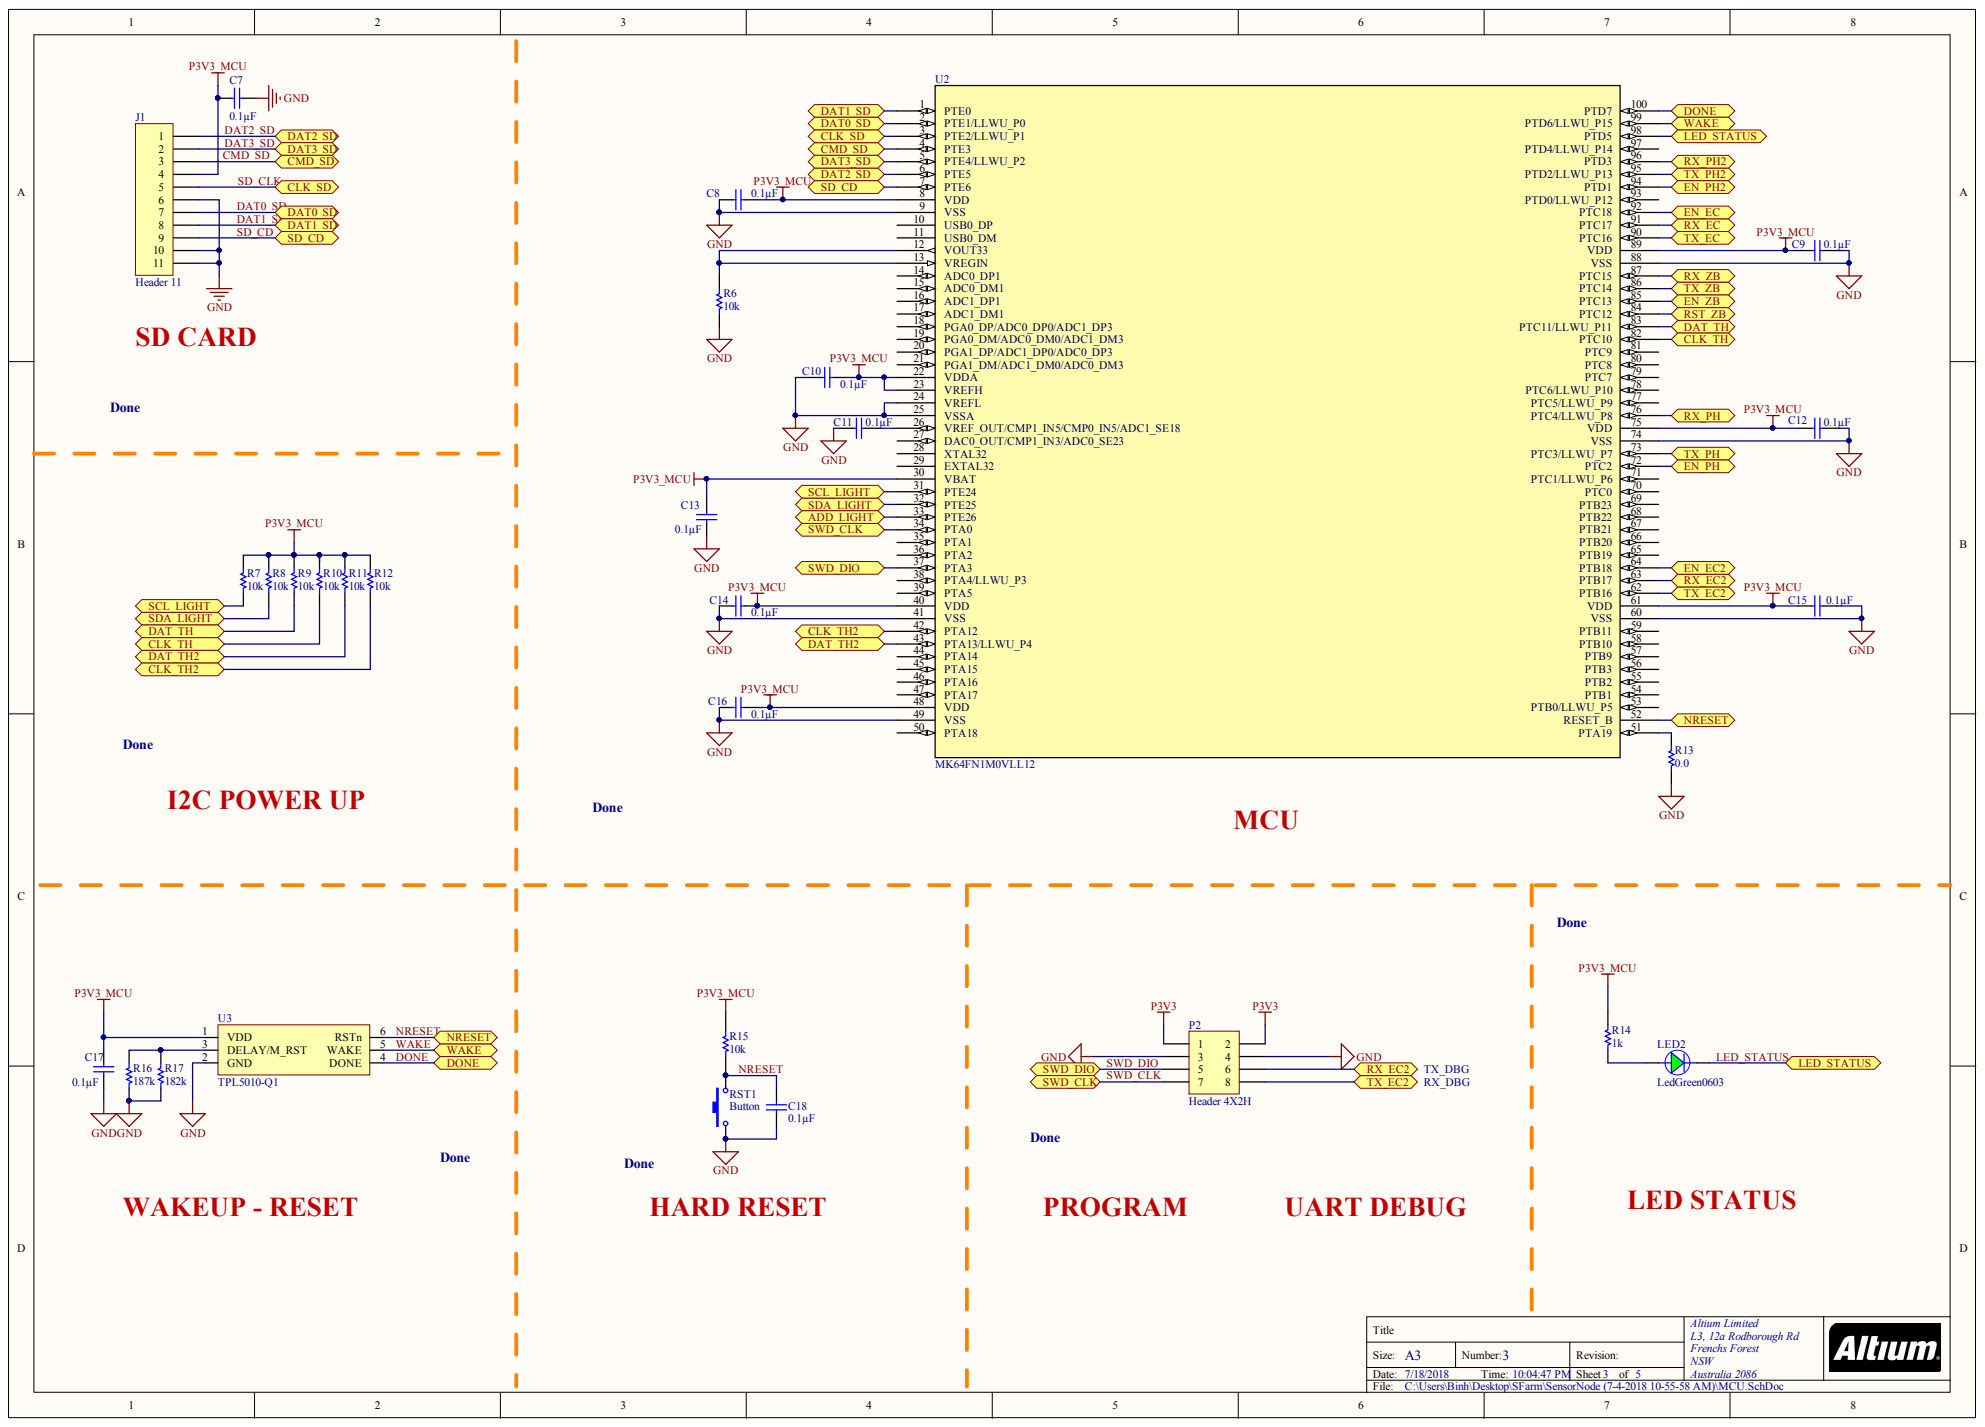
[picture p16: page 3]

VREFH 23

VSSA 25

C:\Users\Binh\Desktop\SFarm\SensorNode (7-4-2018 10-55-58 AM)\MCU.SchDoc

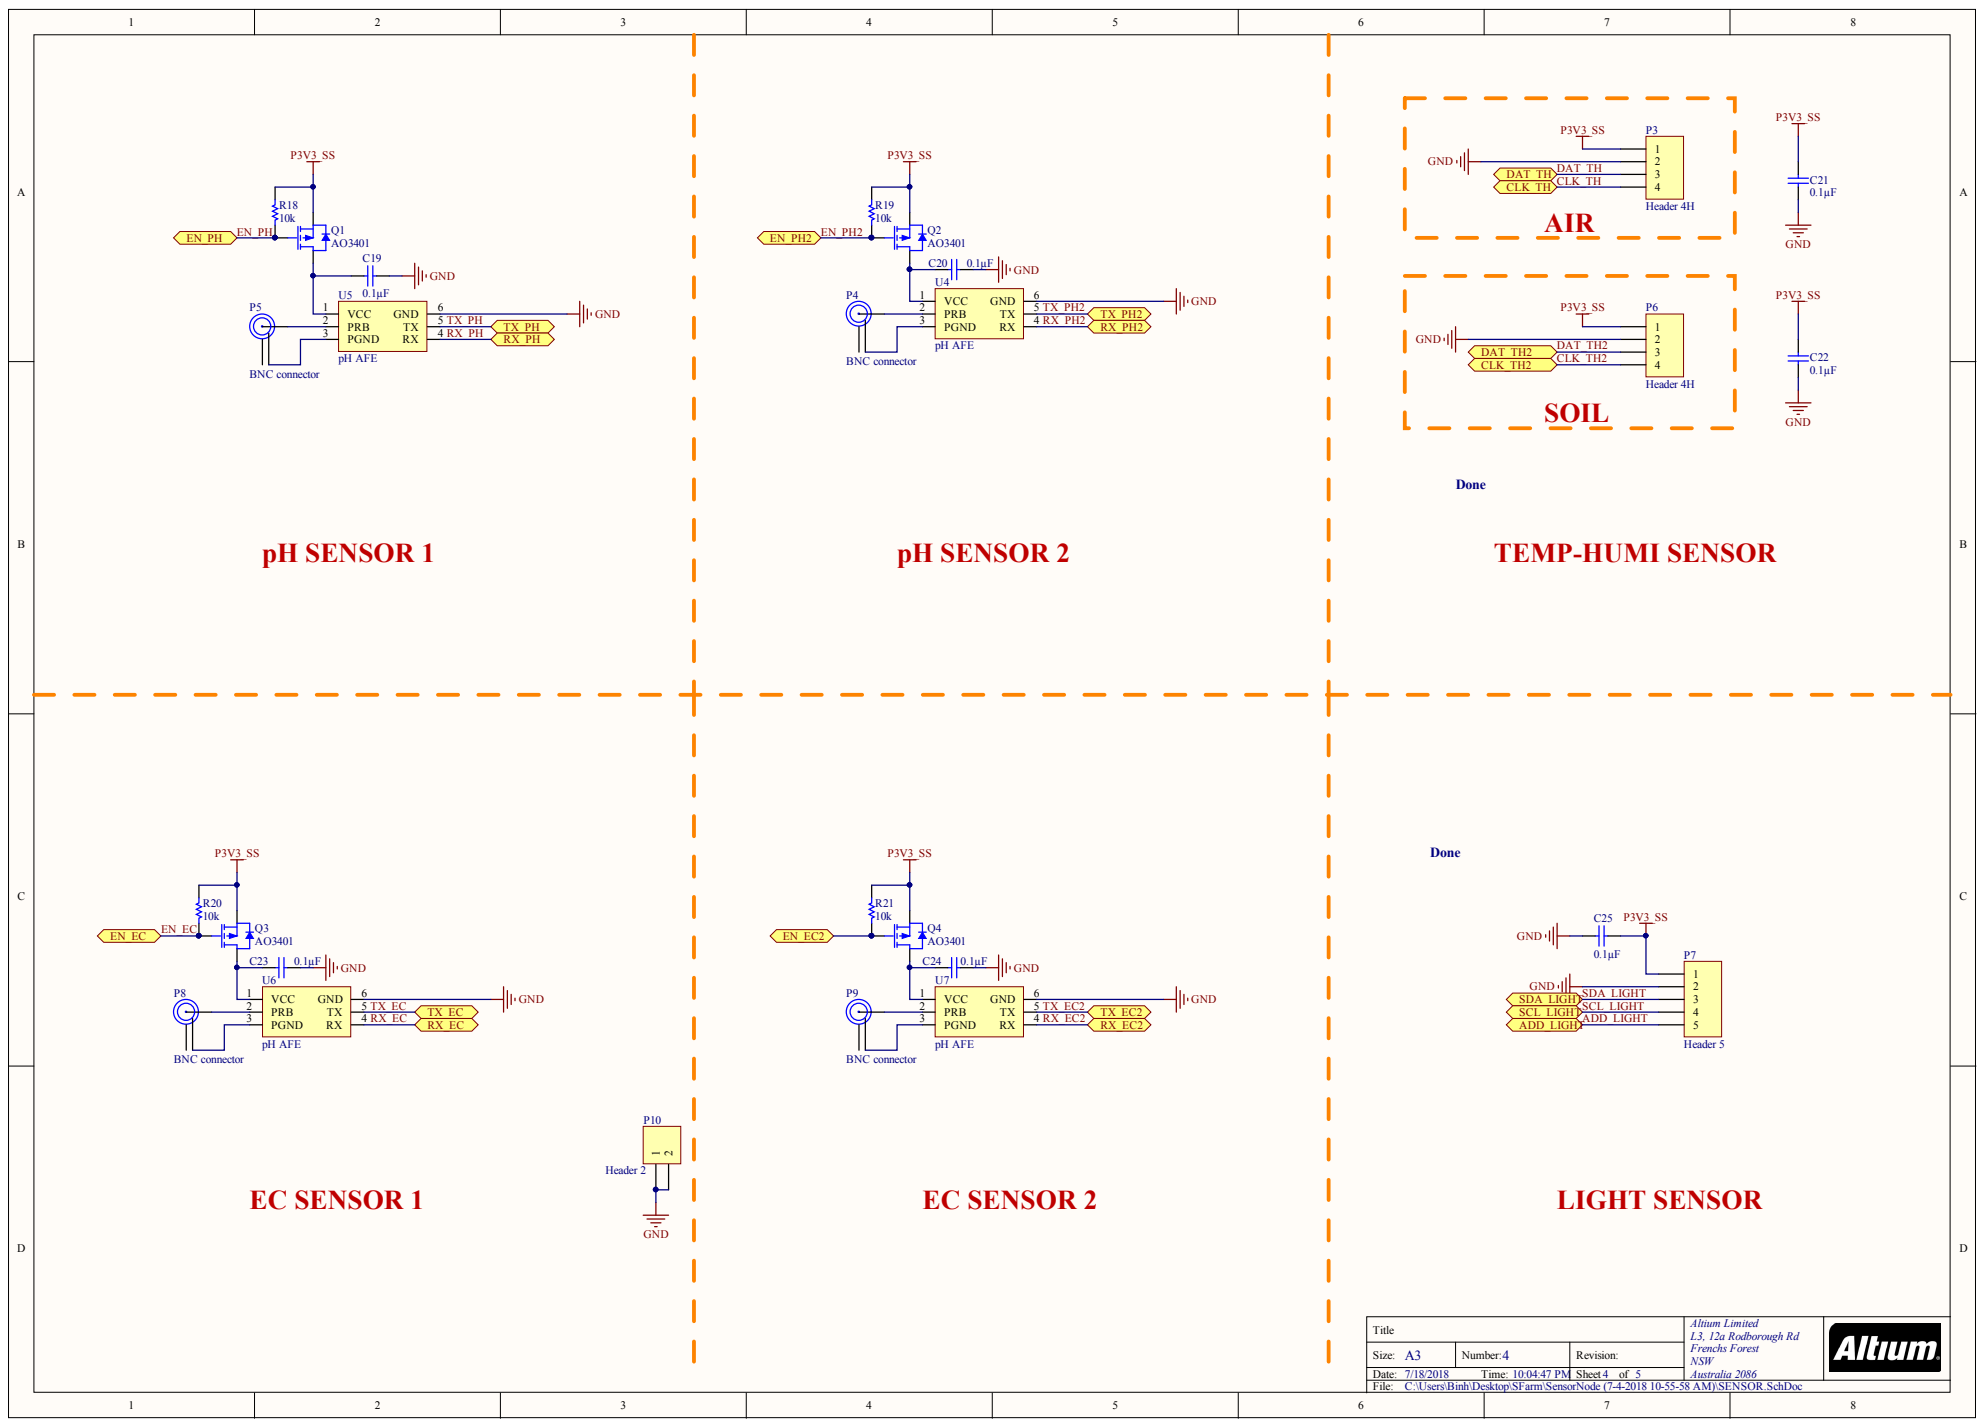
[picture p17: page 4]

C:\Users\Binh\Desktop\SFarm\SensorNode (7-4-2018 10-55-58 AM)\SENSOR.SchDoc

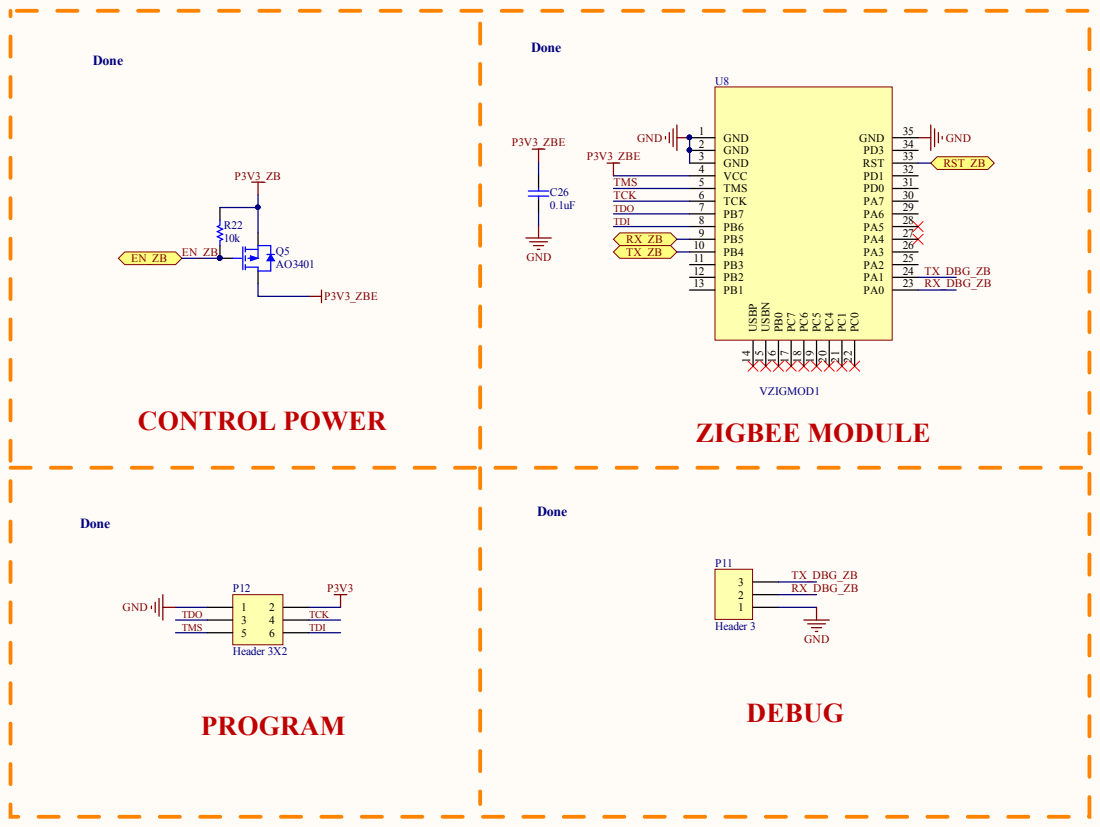
[picture p18: page 5]

C:\Users\Binh\Desktop\SFarm\SensorNode (7-4-2018 10-55-58 AM)\CONNECTIVITY.SchDoc
