thaobk91/smf/HW/WiFi_Shield 182806/PDF/Assembly Guideline.PDF

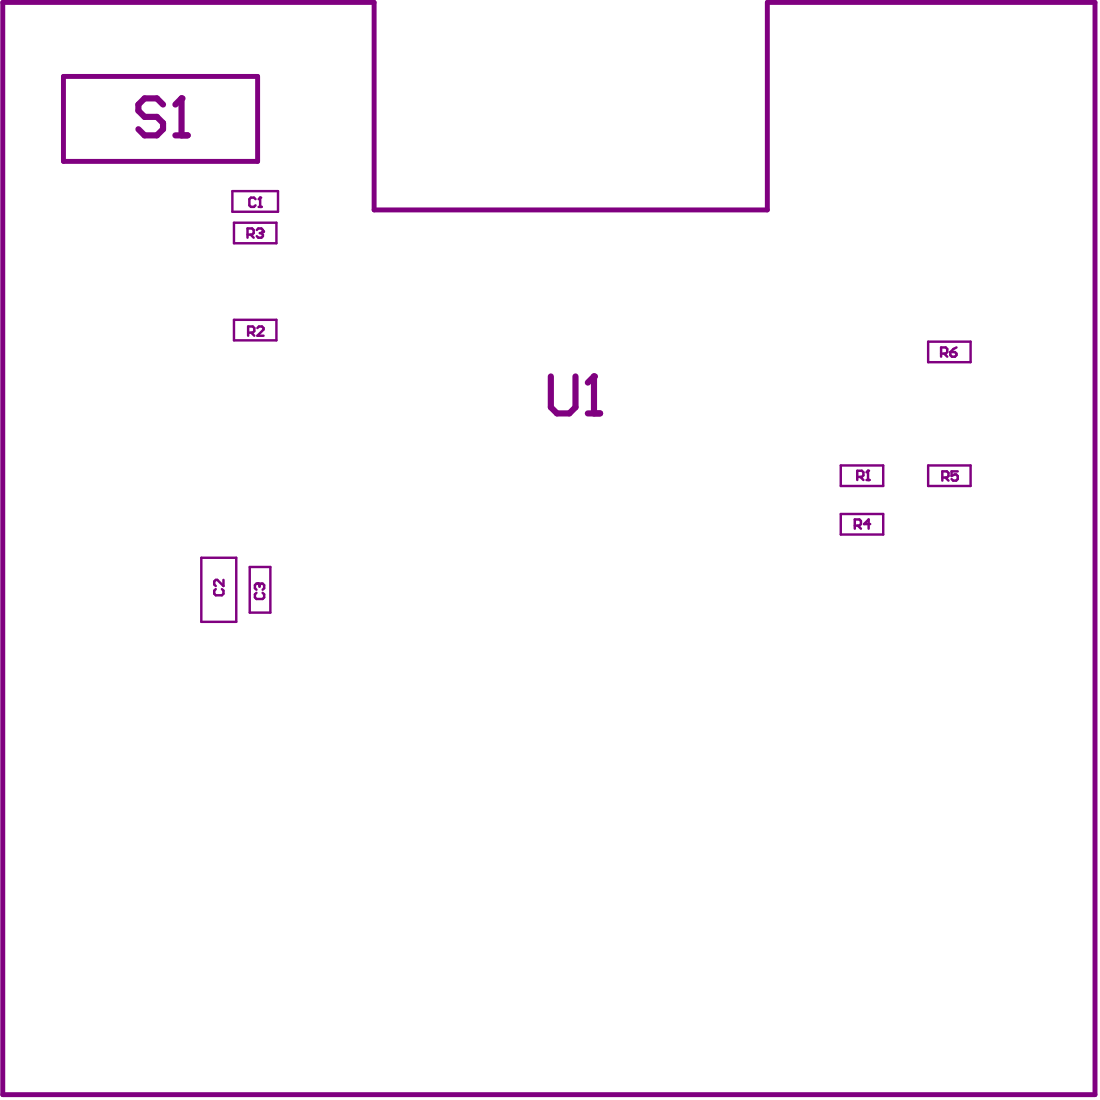
[picture p19: page 1]

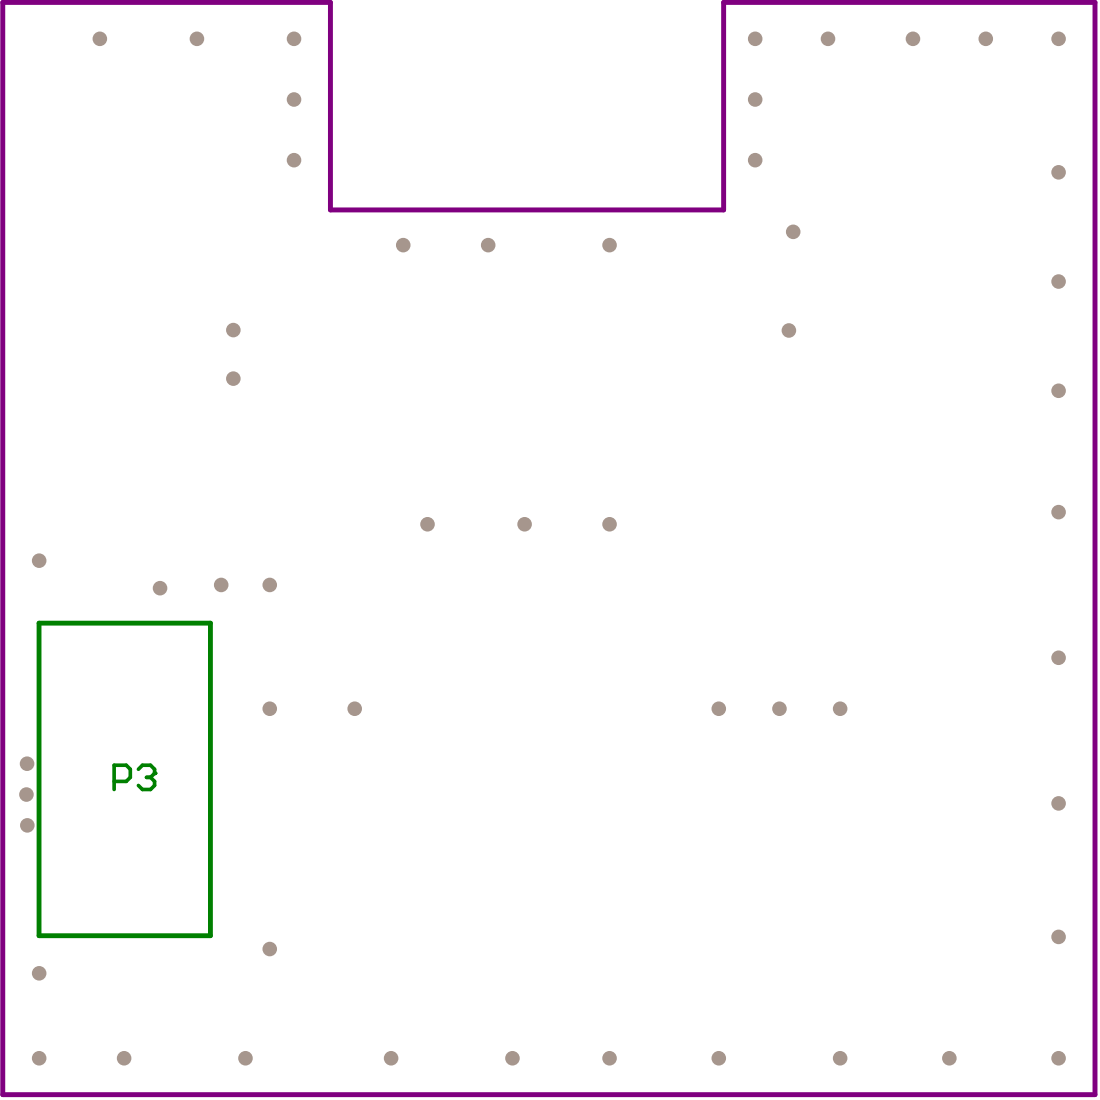
[picture p20: page 2]
