thaobk91/smf/HW/WiFi_Shield 182806/PDF/PCB 3D Print BOT.PDF

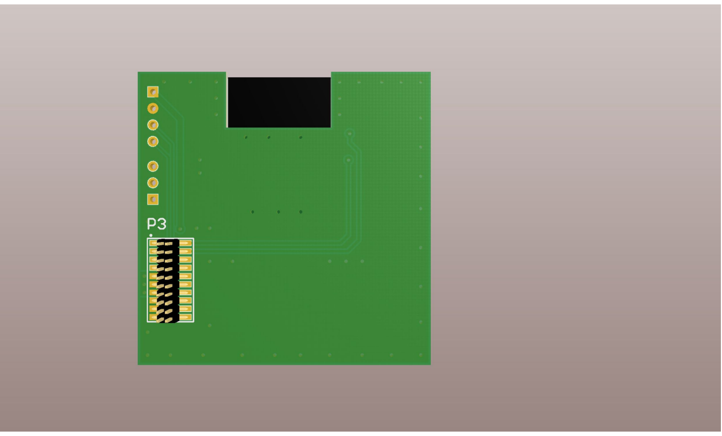
[picture p21: page 1]
