thaobk91/smf/HW/WiFi_Shield 182806/PDF/PCB 3D Print TOP.PDF

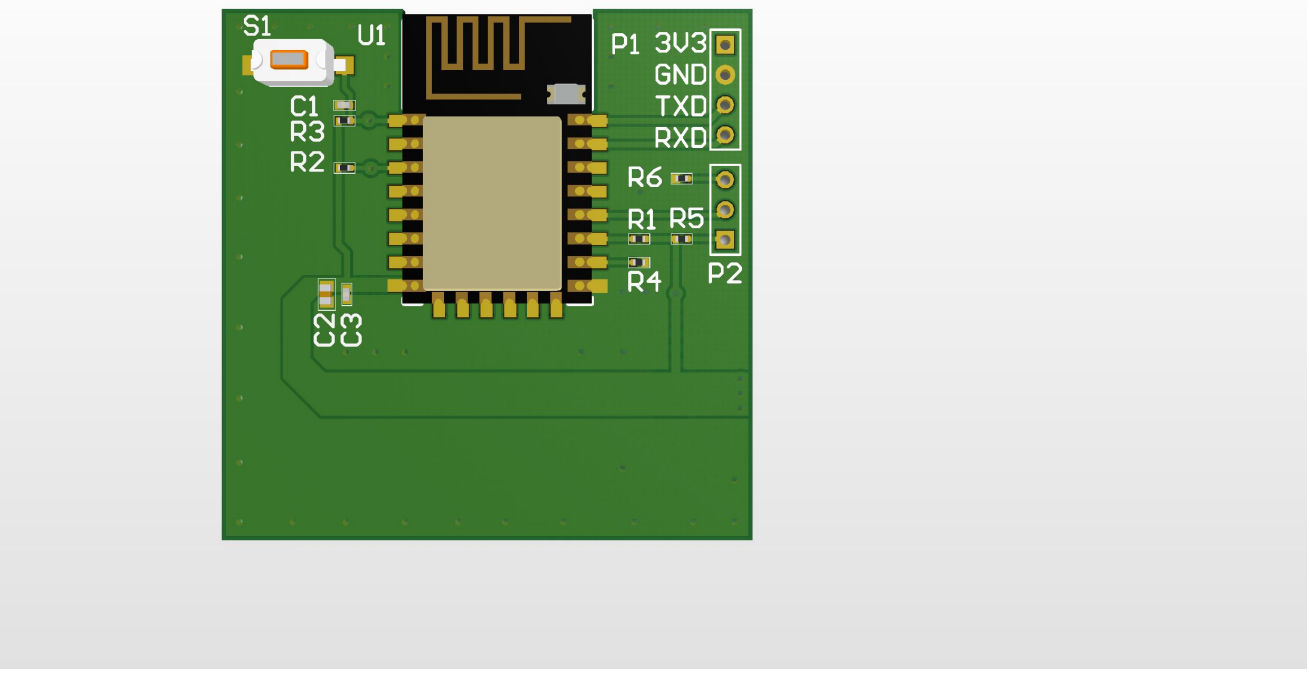
[picture p22: page 1]
