thaobk91/smf/(list of files, drawings)

Other design files:
HW/My Project/SmartFarm/Design/SensorNode (6-30-2018 10-46-34 PM)/BLOCK DIAGRAM.SchDoc
HW/My Project/SmartFarm/Design/SensorNode (6-30-2018 10-46-34 PM)/CONNECTIVITY.SchDoc
HW/My Project/SmartFarm/Design/SensorNode (6-30-2018 10-46-34 PM)/MCU.SchDoc
HW/My Project/SmartFarm/Design/SensorNode (6-30-2018 10-46-34 PM)/POWER.SchDoc
HW/My Project/SmartFarm/Design/SensorNode (6-30-2018 10-46-34 PM)/SENSOR.SchDoc
HW/My Project/SmartFarm/Design/SensorNode (6-30-2018 10-46-34 PM)/SensorNode.PrjPcb
HW/My Project/SmartFarm/Design/SensorNode (6-30-2018 10-46-34 PM)/SFarm.PcbDoc
HW/SFControl-9-24-2018-9-22-00-PM/Block Diagram.SchDoc
HW/SFControl-9-24-2018-9-22-00-PM/Connectivity.SchDoc
HW/SFControl-9-24-2018-9-22-00-PM/Control.SchDoc
HW/SFControl-9-24-2018-9-22-00-PM/Power.SchDoc
HW/SFControl-9-24-2018-9-22-00-PM/SFControl1/SFControl.PcbLib
HW/SFControl-9-24-2018-9-22-00-PM/SFControl1/SFControl.SCHLIB
HW/SFControl-9-24-2018-9-22-00-PM/SFControl.PcbDoc
HW/SFControl-9-24-2018-9-22-00-PM/SFControl.PrjPcb
HW/smf_control/MCU_Schematic.SchDoc
HW/smf_control/Output_Schematic.SchDoc
HW/smf_control/Power_Schematic.SchDoc
HW/smf_control/smf_control.PrjPcb
HW/smf_control/smf_control.SchDoc
HW/smf_control/smf_control_block.SchDoc
