thaobk91/smf/FW/fw_smf_v1.1/fw_smf_gw/Source/main.c

#include "pin_mux.h"
#include "fsl_debug_console.h"
#include "fsl_wdog.h"
#include "fsl_sim.h"
#include "fsl_sysmpu.h"

#include "main.h"
#include "board.h"

/* Task */
#include "ProcessTask.h"
#include "WhoAmITask.h"

#ifdef macroUSE_SDCARD
	#include "SDCardTask.h"
#endif

#include "IOControl.h"
#include "UART.h"
#include "RTC.h"
#include "MQTTClient.h"


/*******************************************************************************
 * Variables
 ******************************************************************************/
//RTC
extern rtc_datetime_t _RTC;

//Uart to Connectivity
uint8_t uUART_CONN_RX_Buffer[macroUART_RX_BUFFER_LENGHT] = {0};
uint8_t uUART_CONN_TX_Buffer[macroUART_TX_BUFFER_LENGHT] = {0};
uint16_t uiUART_CONN_RX_Lenght = 0;

//UART to network
uint8_t uUART_NWK_RX_Buffer[macroUART_RX_BUFFER_LENGHT] = {0};
uint8_t uUART_NWK_TX_Buffer[macroUART_TX_BUFFER_LENGHT] = {0};
uint16_t uiUART_NWK_RX_Lenght = 0;

//Buffer MQTT (Ethernet)
uint8_t uETH_MQTT_RX_Buffer[macroMQTT_RX_BUFFER_LENGHT] = {0};
uint8_t uETH_MQTT_TX_Buffer[macroMQTT_TX_BUFFER_LENGHT] = {0};

//event
uint16_t Event_IO = EVENT_IDLE;

//Task
taskHandle_t xTask =
{
	.uiProcessTask_Finish	= 1,

	.uiWamiTask_Finish		= 1,

#ifdef macroUSE_SDCARD
	.uiSDCardTask_Finish	= 1,
#endif
};

//WDT
static WDOG_Type *xWdog_Base = WDOG;

//ID Gw
uint8_t uIDGw[18] = {0};


//Who am i
WhoAmI _WhoAmI =
{
	.Network =
	{
		.Ethernet		= false,
		.Wifi			= false,
		._3G			= false,
		._2G			= false,
		.ConnectionOK	= false,
	},
	.Connectivity =
	{
		.Zigbee			= false,
		.Sub1Ghz		= false,
	}
};

//response
bool isResponse = false;

//sync RTC
bool bRTC_Sync = false;


/******************************** Function ************************************/
void vMain_InitWatchdog( void );
void vMain_GetUniqueID(uint8_t *pID);
/******************************************************************************/



/*******************************************************************************
 * Function		: int main(void)
 * Description	: main
 * Param		: none
 * Return		: none
*******************************************************************************/
int main(void)
{
    /* Init board hardware. */
    BOARD_InitPins();

//#if defined(macroCONNECTIVITY_ETH) || defined(macroUSE_SDCARD)
//    macroETH_POWER_ON();
//	BOARD_BootClockRUN();
//#else
	BOARD_BootClockVLPR();
//#endif
	SYSMPU_Enable(SYSMPU, false);
	
	vMain_Peripheral_Init();
    
	APP_DEBUG("\r\n");
    APP_DEBUG("*******************************************************************\r\n");
    APP_DEBUG("******************->> SMF Project is Welcome <<-*******************\r\n");
    APP_DEBUG("*******************************************************************\r\n");
    APP_DEBUG("\r\n");
	
	vMain_GetUniqueID( uIDGw );
	APP_DEBUG("--- Main: ID Gw = %s\r\n", uIDGw);
	
	APP_DEBUG("--- Main: Init Peripheral successfully\r\n");
	
	//Process task
	if(xTaskCreate(vProcessTask_Run	, "vProcessTask_Run"	, configMINIMAL_STACK_SIZE + 1300	, NULL, macroPRIORITY_TASK_PROCESS	, &xTask.xTaskHandle_Process) != pdPASS)
		APP_DEBUG("--- Main: Failed to create process task\r\n");

	//Who am i task
	if(xTaskCreate(vWhoAmITask_Run	, "vWhoAmITask_Run"		, configMINIMAL_STACK_SIZE + 256	, NULL, macroPRIORITY_TASK_WhoAmI	, &xTask.xTaskHandle_WhoAmI) != pdPASS)
		APP_DEBUG("--- Main: Failed to create Who Am I task\r\n");

	//SD Card task
#ifdef macroUSE_SDCARD
	if(xTaskCreate(vSDCardTask_Run	, "vSDCardTask_Run"		, configMINIMAL_STACK_SIZE + 1024*3	, NULL, macroPRIORITY_TASK_SDCard	, &xTask.xTaskHandle_SDCard) != pdPASS)
		APP_DEBUG("--- Main: Failed to create SD Card task\r\n");
#endif
   	
    vTaskStartScheduler();
    
    for (;;);
}




/******************************************************************************
 * Function		: void vMain_Peripheral_Init( void )
 * Description	: Ham khoi tao ngoai vi
 * Param		: none
 * Return		: none
*******************************************************************************/
void vMain_Peripheral_Init( void )
{
	vMain_InitWatchdog();
	
	BOARD_InitDebugConsole();
	
	//Set RTC
	vRTC_Init(&_RTC);

	//network UART
	vUART_Init(macroUART_NETWORK_BASE, macroUART_NETWORK_CLKSRC, macroUART_NETWORK_BAUDRATE, true, macroUART_NETWORK_IRQn);
	
	//connectivity UART
	vUART_Init(macroUART_CONNECTIVITY_BASE, macroUART_CONNECTIVITY_CLKSRC, macroUART_CONNECTIVITY_BAUDRATE, true, macroUART_CONNECTIVITY_IRQn);
}




/******************************************************************************
 * Function		: void vMain_Peripheral_DeInit( void )
 * Description	: Ham stop ngoai vi
 * Param		: none
 * Return		: none
*******************************************************************************/
void vMain_Peripheral_DeInit( void )
{
	WDOG_Deinit( xWdog_Base );
	
	//Deinit uart
	vUART_DeInit( macroUART_NETWORK_BASE );
	vUART_DeInit( macroUART_CONNECTIVITY_BASE );
	
	//Deinit rtc
	RTC_Deinit( RTC );
	
	DbgConsole_Deinit();
}	




/******************************************************************************
 * Function		: void macroUART_NETWORK_IRQHandler( void )
 * Description	: Network uart rx interrupt0x 
 * Param		: none
 * Return		: none
*******************************************************************************/
void macroUART_NETWORK_IRQHandler( void )
{
//	if ((kUART_RxDataRegFullFlag | kUART_RxOverrunFlag) & UART_GetStatusFlags(macroUART_NETWORK_BASE))
	if (UART_GetStatusFlags(macroUART_NETWORK_BASE))
    {
		uUART_NWK_RX_Buffer[uiUART_NWK_RX_Lenght] = UART_ReadByte( macroUART_NETWORK_BASE );
//		APP_DEBUG("--- Here. buf = %s\r\n", uUART_NWK_RX_Buffer);
		
        if(uiUART_NWK_RX_Lenght >= macroUART_RX_BUFFER_LENGHT - 1)
		{
			memset(uUART_NWK_RX_Buffer, 0, uiUART_NWK_RX_Lenght);
			uiUART_NWK_RX_Lenght = 0;
		}
        else if(uUART_NWK_RX_Buffer[uiUART_NWK_RX_Lenght] == macroPACKET_STRING_ENDCHAR)
        {
        	vMain_setEvent(EVENT_UART_NWK_RECEIVED);
        }
		uiUART_NWK_RX_Lenght++;
    }
//#if defined __CORTEX_M && (__CORTEX_M == 4U)
//    __DSB();
//#endif
}




/******************************************************************************
 * Function		: void macroUART_CONNECTIVITY_IRQHandler( void )
 * Description	: UART connectivity interrupt
 * Param		: none
 * Return		: none
*******************************************************************************/
void macroUART_CONNECTIVITY_IRQHandler( void )
{
	if ((kUART_RxDataRegFullFlag | kUART_RxOverrunFlag) & UART_GetStatusFlags(macroUART_CONNECTIVITY_BASE))
    {
        uUART_CONN_RX_Buffer[uiUART_CONN_RX_Lenght] = UART_ReadByte( macroUART_CONNECTIVITY_BASE );
		
        if(uiUART_CONN_RX_Lenght >= macroUART_RX_BUFFER_LENGHT - 1)
		{
			memset(uUART_CONN_RX_Buffer, 0, uiUART_CONN_RX_Lenght);
			uiUART_CONN_RX_Lenght = 0;
		}
        else if(uUART_CONN_RX_Buffer[uiUART_CONN_RX_Lenght] == macroPACKET_STRING_ENDCHAR)
        {
        	vMain_setEvent(EVENT_UART_CONN_RECEIVED);
        }
		uiUART_CONN_RX_Lenght++;
    }
#if defined __CORTEX_M && (__CORTEX_M == 4U)
    __DSB();
#endif
}





/******************************************************************************
 * Function		: void vMain_InitWatchdog( void )
 * Description	: Ham khoi tao WDT
 * Param		: none
 * Return		: none
*******************************************************************************/
void vMain_InitWatchdog( void )
{
    wdog_config_t xWDTConfig;

    WDOG_GetDefaultConfig( &xWDTConfig );
    xWDTConfig.timeoutValue = macroTIME_WATCHDOG_DELAY;
    
    /* wdog refresh test in window mode */
    WDOG_Init(xWdog_Base, &xWDTConfig);
	
	for (uint32_t i = 0; i < WDOG_WCT_INSTRUCITON_COUNT; i++)
        (void)xWdog_Base->RSTCNT;
    
    /* Delay watchdog 1 second */
    while (((uint32_t)((((uint32_t)xWdog_Base->TMROUTH) << 16U) | (xWdog_Base->TMROUTL))) < (1000));
    APP_DEBUG("--- Main: Init watchdog time delay: %d ms complete\r\n", macroTIME_WATCHDOG_DELAY);
}




/******************************************************************************
 * Function		: void vMain_GetUniqueID(char *pcDeviceID)
 * Description	: Ham lay Unique ID of mcu
 * Param		: pcDeviceID - ID device of mcu
 * Return		: none
*******************************************************************************/
void vMain_GetUniqueID(uint8_t *pID)
{
	sim_uid_t xSim_UID;
	char uChar[65] = "0123456789ABCDEFGHIJKLMNOPQRSTUVWXYZabcdefghijklmnopqrstuvwxyz_-";
	
	SIM_GetUniqueId(&xSim_UID);
	pID[0] = '0';
	pID[1] = uChar[((xSim_UID.H >> 20) & 0xFFF) / 64]; 
	pID[2] = uChar[((xSim_UID.H >> 20) & 0xFFF) % 64];
	pID[3] = uChar[((xSim_UID.H >> 8) & 0xFFF) / 64];
	pID[4] = uChar[((xSim_UID.H >> 8) & 0xFFF) % 64];
	pID[5] = uChar[(((xSim_UID.H & 0xFF) << 4) | (xSim_UID.ML >> 28)) / 64];
	pID[6] = uChar[(((xSim_UID.H & 0xFF) << 4) | (xSim_UID.ML >> 28)) % 64];
	pID[7] = uChar[((xSim_UID.ML >> 16) & 0xFFF) / 64];
	pID[8] = uChar[((xSim_UID.ML >> 16) & 0xFFF) % 64];
	pID[9] = uChar[((xSim_UID.ML >> 4) & 0xFFF) / 64];
	pID[10] = uChar[((xSim_UID.ML >> 4) & 0xFFF) % 64];
	pID[11] = uChar[((xSim_UID.ML & 0xF) | (xSim_UID.L >> 24)) / 64];
	pID[12] = uChar[((xSim_UID.ML & 0xF) | (xSim_UID.L >> 24)) % 64];
	pID[13] = uChar[((xSim_UID.L >> 12) & 0xFFF) / 64];
	pID[14] = uChar[((xSim_UID.L >> 12) & 0xFFF) % 64];
	pID[15] = uChar[(xSim_UID.L & 0xFFF) / 64];
	pID[16] = uChar[(xSim_UID.L & 0xFFF) % 64];
}



/******************************************************************************
 * Function		: void vMain_RefreshWDT( void )
 * Description	: refresh wdt
 * Param		: none
 * Return		: none
*******************************************************************************/
void vMain_RefreshWDT( void )
{
	WDOG_Refresh(xWdog_Base);
}




/******************************************************************************
 * Function		: void vMain_setEvent(uint16_t Event)
 * Description	: set event
 * Param		: none
 * Return		: none
*******************************************************************************/
void vMain_setEvent(uint16_t Event)
{
	Event_IO |= Event;
}




/******************************************************************************
 * Function		: uint16_t uiMain_getEvent( void )
 * Description	: get event
 * Param		: none
 * Return		: none
*******************************************************************************/
uint16_t uiMain_getEvent( void )
{
	uint16_t uEvent = Event_IO;
	Event_IO = EVENT_IDLE;
	return uEvent;
}
