thaobk91/smf/FW/fw_smf_v1.1/fw_smf_zigbee/fw_zigbee_control/Source/AppData.h

#ifndef __APPDATA_H
#define __APPDATA_H

#include "Main.h"


#define APPDATA_ENDPOINT           			8
#define APPDATA_PROFILE						0x0F04
#define APPDATA_DEVICE_ID					0x0001
#define APPDATA_DEVICE_VERSION				0
#define APPDATA_FLAGS						0

/********************************* CLUSTER ************************************/
#define APPDATA_MAX_CLUSTERS_IN				1
#define APPDATA_MAX_CLUSTERS_OUT			1

//Cluster ID
#define APPDATA_CLUSTER_COOR_OUT_NODE_IN	0xD001
#define APPDATA_CLUSTER_COOR_IN_NODE_OUT	0xD002


/*********************************** IO ***************************************/
#define macroMAX_OUTPUT_VAC					6

//Output
#define macroOUTPUT_1_PORT					GPIO_C_BASE
#define macroOUTPUT_1_PIN					GPIO_PIN_7
#define macroOUTPUT_1_ON()					GPIOPinWrite( macroOUTPUT_1_PORT, macroOUTPUT_1_PIN, 0)
#define macroOUTPUT_1_OFF()					GPIOPinWrite( macroOUTPUT_1_PORT, macroOUTPUT_1_PIN, macroOUTPUT_1_PIN)
#define macroREAD_OUTPUT_1()				GPIOPinRead( macroOUTPUT_1_PORT, macroOUTPUT_1_PIN)

#define macroOUTPUT_2_PORT					GPIO_C_BASE
#define macroOUTPUT_2_PIN					GPIO_PIN_6
#define macroOUTPUT_2_ON()					GPIOPinWrite( macroOUTPUT_2_PORT, macroOUTPUT_2_PIN, 0)
#define macroOUTPUT_2_OFF()					GPIOPinWrite( macroOUTPUT_2_PORT, macroOUTPUT_2_PIN, macroOUTPUT_2_PIN)
#define macroREAD_OUTPUT_2()				GPIOPinRead( macroOUTPUT_2_PORT, macroOUTPUT_2_PIN)

#define macroOUTPUT_3_PORT					GPIO_C_BASE
#define macroOUTPUT_3_PIN					GPIO_PIN_5
#define macroOUTPUT_3_ON()					GPIOPinWrite( macroOUTPUT_3_PORT, macroOUTPUT_3_PIN, 0)
#define macroOUTPUT_3_OFF()					GPIOPinWrite( macroOUTPUT_3_PORT, macroOUTPUT_3_PIN, macroOUTPUT_3_PIN)
#define macroREAD_OUTPUT_3()				GPIOPinRead( macroOUTPUT_3_PORT, macroOUTPUT_3_PIN)

#define macroOUTPUT_4_PORT					GPIO_C_BASE
#define macroOUTPUT_4_PIN					GPIO_PIN_4
#define macroOUTPUT_4_ON()					GPIOPinWrite( macroOUTPUT_4_PORT, macroOUTPUT_4_PIN, 0)
#define macroOUTPUT_4_OFF()					GPIOPinWrite( macroOUTPUT_4_PORT, macroOUTPUT_4_PIN, macroOUTPUT_4_PIN)
#define macroREAD_OUTPUT_4()				GPIOPinRead( macroOUTPUT_4_PORT, macroOUTPUT_4_PIN)

#define macroOUTPUT_5_PORT					GPIO_C_BASE
#define macroOUTPUT_5_PIN					GPIO_PIN_1
#define macroOUTPUT_5_ON()					GPIOPinWrite( macroOUTPUT_5_PORT, macroOUTPUT_5_PIN, 0)
#define macroOUTPUT_5_OFF()					GPIOPinWrite( macroOUTPUT_5_PORT, macroOUTPUT_5_PIN, macroOUTPUT_5_PIN)
#define macroREAD_OUTPUT_5()				GPIOPinRead( macroOUTPUT_5_PORT, macroOUTPUT_5_PIN)

#define macroOUTPUT_6_PORT					GPIO_C_BASE
#define macroOUTPUT_6_PIN					GPIO_PIN_0
#define macroOUTPUT_6_ON()					GPIOPinWrite( macroOUTPUT_6_PORT, macroOUTPUT_6_PIN, 0)
#define macroOUTPUT_6_OFF()					GPIOPinWrite( macroOUTPUT_6_PORT, macroOUTPUT_6_PIN, macroOUTPUT_6_PIN)
#define macroREAD_OUTPUT_6()				GPIOPinRead( macroOUTPUT_6_PORT, macroOUTPUT_6_PIN)

//Led status
#define macroLED_STATUS_PORT				GPIO_B_BASE
#define macroLED_STATUS_PIN					GPIO_PIN_3
#define macroLED_STATUS_ON()				GPIOPinWrite( macroLED_STATUS_PORT, macroLED_STATUS_PIN, 0)
#define macroLED_STATUS_OFF()				GPIOPinWrite( macroLED_STATUS_PORT, macroLED_STATUS_PIN, macroLED_STATUS_PIN)

//Nano timer done
#define macroNANO_TIMER_DONE_PORT			GPIO_D_BASE
#define macroNANO_TIMER_DONE_PIN			GPIO_PIN_0
#define macroNANO_TIMER_DONE_ON()			GPIOPinWrite( macroNANO_TIMER_DONE_PORT, macroNANO_TIMER_DONE_PIN, macroNANO_TIMER_DONE_PIN)
#define macroNANO_TIMER_DONE_OFF()			GPIOPinWrite( macroNANO_TIMER_DONE_PORT, macroNANO_TIMER_DONE_PIN, 0)
												

/*********************************** DATA *************************************/
//Type Packet
#define macroTYPE_PACKET_DATA				"DATA"
#define macroTYPE_PACKET_CONF				"CONF"
#define macroTYPE_PACKET_REQS				"REQS"
#define macroTYPE_PACKET_CTRL				"CTRL"

//Type device
#define macroTYPE_DEVICE					"SMF_CTRLN"

//ID Data
#define macroCONTROL_STATUS					"CtrlStat"
#define macroDEVICE_STATUS					"D_State"

//ID Config
#define macroCONFIG_ON_OFF_OUTVAC_1			"OutVAC_1"
#define macroCONFIG_ON_OFF_OUTVAC_2			"OutVAC_2"
#define macroCONFIG_ON_OFF_OUTVAC_3			"OutVAC_3"
#define macroCONFIG_ON_OFF_OUTVAC_4			"OutVAC_4"
#define macroCONFIG_ON_OFF_OUTVAC_5			"OutVAC_5"
#define macroCONFIG_ON_OFF_OUTVAC_6			"OutVAC_6"

//ID Request
#define macroREQUEST_OUTVAC_STATUS			"ALL"

//ID Control
#define macroCONTROL_OUT_VAC				"OutVAC"




/********************************* Variable ***********************************/
extern cId_t GenericApp_InClusterList[APPDATA_MAX_CLUSTERS_IN];
extern cId_t GenericApp_Out_ClusterList[APPDATA_MAX_CLUSTERS_OUT];
extern SimpleDescriptionFormat_t GenericApp_SimpleDesc;
extern endPointDesc_t xDataEPDesc;


typedef struct
{
	uint8_t CurrentTime;
	uint8_t	Begin;
	uint8_t End;
}AutoOutput;


#endif
