thaobk91/smf/FW/fw_smf_v1.1/fw_smf_zigbee/fw_zigbee_control/Source/Main.h

#ifndef MAIN_H
#define MAIN_H

#include "string.h"
#include "stdio.h"
#include "stdlib.h"

#include "OSAL.h"
#include "AF.h"
#include "ZDApp.h"
#include "ZDObject.h"
#include "ZDProfile.h"
#include "OnBoard.h"

#include "ZMAC.h"
/* HAL */
#include "ZComDef.h"

#include "AppData.h"
#include "ZigbeeIO.h"
#include "UserUART.h"


//event function
#define macroLOOP_EVENT(TASK_ID, EVENT_ID, TIMEOUT)				osal_start_timerEx(TASK_ID, EVENT_ID, TIMEOUT)
#define macroSET_EVENT(TASK_ID, EVENT_ID)						osal_set_event(TASK_ID, EVENT_ID)

//event
#define EVENT_LED_STATUS					0x0001
#define EVENT_ZIGBEE_RECV					0x0002
#define EVENT_SEND_MESSAGE					0x0004
#define EVENT_SEND_OUT_STATE				0x0008


//event time
#define macroTIME_EVENT_LED_STATUS			100
#define macroTIME_EVENT_RESEND_DATA			500
#define macroTIME_EVENT_RESEND_OUT_STATE	3000



 
/*********************************************************************
 * FUNCTIONS
 */
/*******************************************************************************
* Function: void vMain_Init( byte task_id )
* Description: main task init
* Param: task_id - task id
* Return: none
*******************************************************************************/
void vMain_Init( byte task_id );



/*******************************************************************************
* Function: UINT16 uiMain_ProcessEvent( byte task_id, UINT16 events )
* Description: main task event process
* Param: 
*		+ task_id: task id
*		+ events: event task
* Return: none
*******************************************************************************/
UINT16 uiMain_ProcessEvent( byte task_id, UINT16 events );



#endif /* GENERICAPP_H */
