thaobk91/smf/FW/fw_smf_v1.1/fw_smf_sensor_H/Source/Sensor/SS_TempAndHumi.h

#ifndef __SS_TEMPANDHUMI_H
#define __SS_TEMPANDHUMI_H

//use sensor type
//#define USE_SHT1X



void vSS_TempAndHumi_Air_Index( float *fTemp, float *fHumi );




void vSS_TempAndHumi_Soil_Index( float *fTemp, float *fHumi );



#endif
