thaobk91/smf/FW/fw_smf_v1.1/fw_smf_sensor_H/Source/Sensor/SS_EC.c

#include "SS_EC.h"
#include "UART.h"
//#include "main.h"


void vSS_EC_Init( void )
{
#ifdef USE_EC_ATLAS
	vSS_EC_Atlas_Init();
#endif
}



void vSS_EC_Read( float fTemp )
{
#ifdef USE_EC_ATLAS
	vSS_EC_Atlas_Read( fTemp );
#endif
}
