thaobk91/smf/FW/fw_smf_v1.1/fw_smf_sensor_H/Source/Sensor/SS_PH.c

#include "SS_PH.h"



void vSS_PH_Init(void)
{
#ifdef USE_PH_ATLAS
	vSS_PH_Atlas_Init();
#endif
}
/******************************************************************************


*******************************************************************************/
void vSS_PH_Read( float fTemp )
{
#ifdef USE_PH_ATLAS
	vSS_PH_Atlas_Read( fTemp );
#endif
}
